aa236b-winter-2019/FlightBoards/README.md

# FlightBoards
Home of PCB Designs

### Notes: 
* Commit 2427577 Contains Motherboard, Solar Panel X and Solar Panel Y documents that correspond to first revision of these boards
* Commit daf960a contains Solar Panel Z documents that correspond to first revision
