aa236b-winter-2019/FlightBoards/CAD_Models/SolarCellY_v2_6milmag.SLDASM

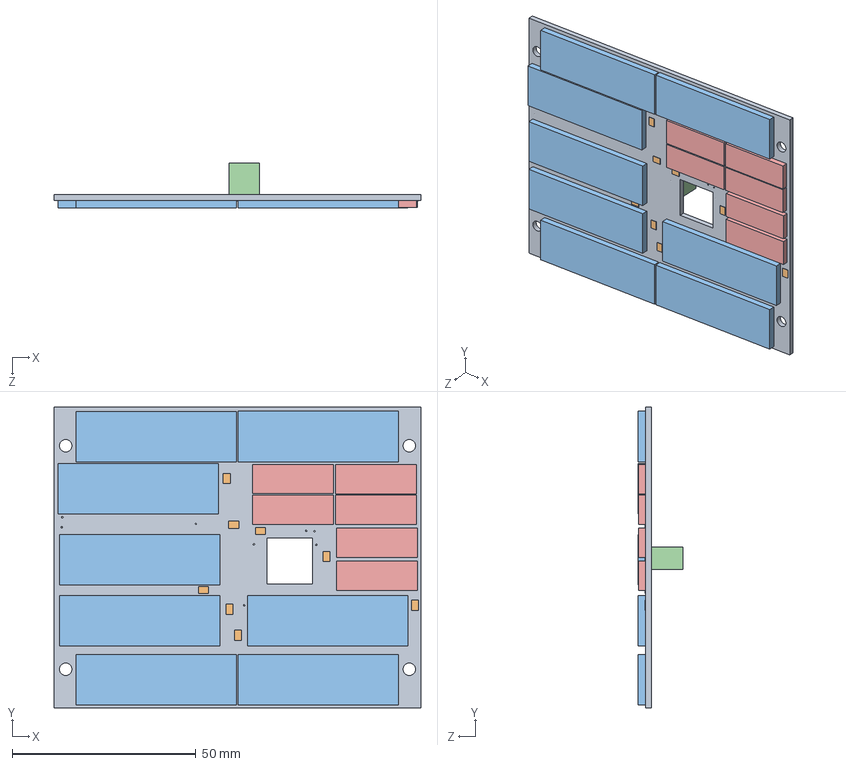
[picture p1: CAD file, 2019-02-27]
CAD_Models/SolarCellY_v2_6milmag.SLDASM
100.0 x 82.0 x 12.3 mm
Board.step
SB_DIODE.step x 8
SLMD121H04L.step x 8
M20-8760342.step
KXOB22-04X3F.step x 6
