aa236b-winter-2019/FlightBoards/CAD_Models/SolarZ.SLDASM

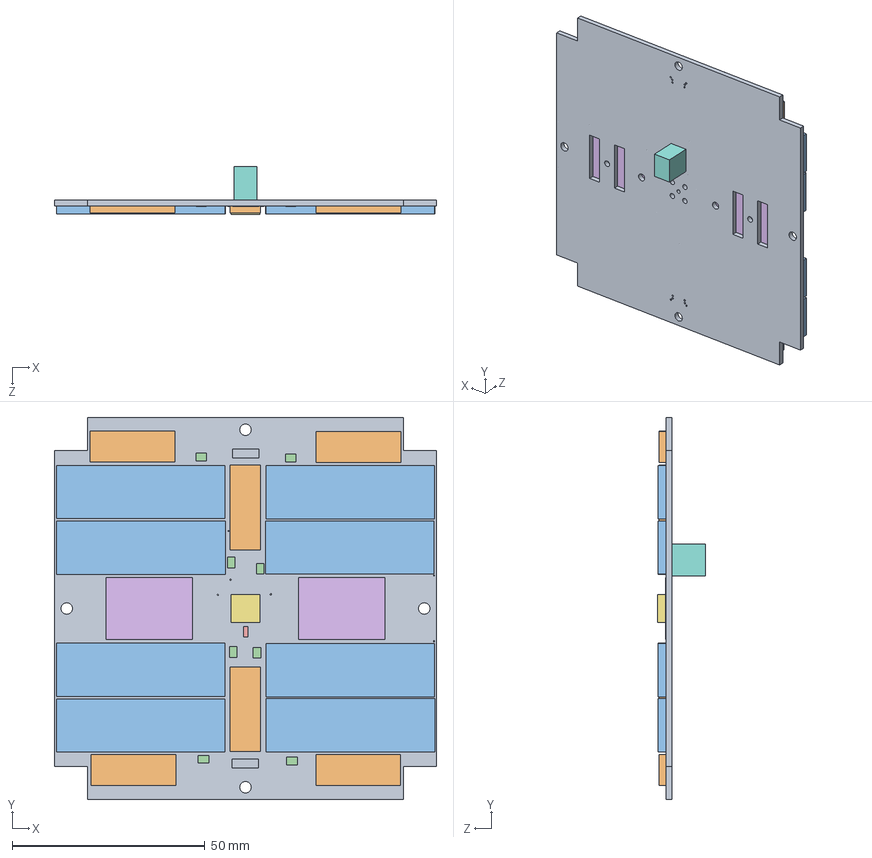
[picture p2: CAD file, 2019-02-27]
CAD_Models/SolarZ.SLDASM
99.0 x 99.0 x 12.5 mm
Board.step
KXOB22-04X3F.step x 6
SLMD121H04L.step x 8
SB_DIODE.step x 8
BALUN.step
TAPE.step x 2
BU-SMA-V.step
M20-8760342.step
BURN_WIRE.step x 2
