aa236b-winter-2019/FlightBoards/CAD_Models/SolarCellX_v2_6milmag.SLDASM

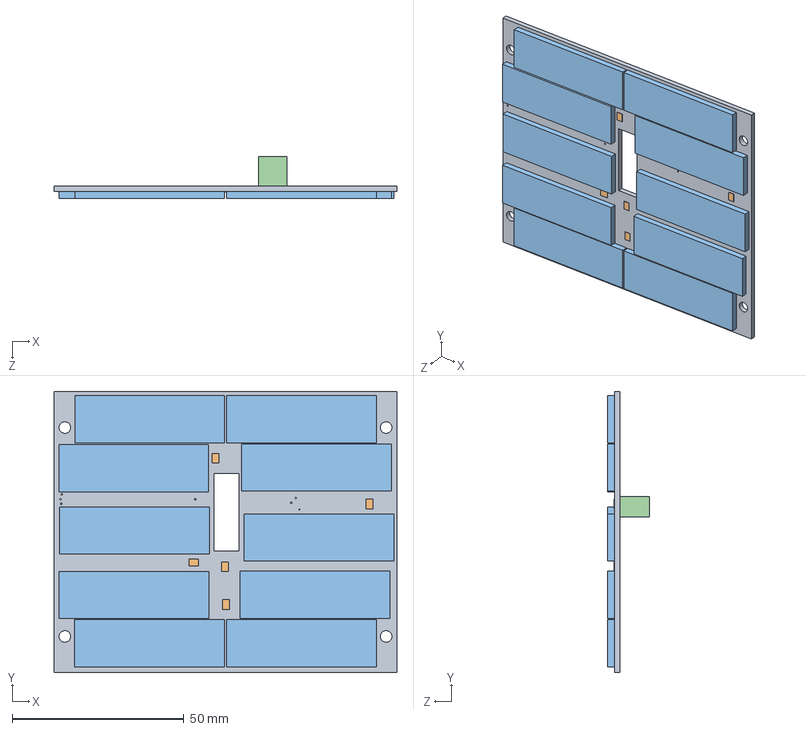
[picture p3: CAD file, 2019-02-27]
CAD_Models/SolarCellX_v2_6milmag.SLDASM
100.0 x 82.0 x 12.3 mm
Board.step
SB_DIODE.step x 5
SLMD121H04L.step x 10
M20-8760342.step
