aa236b-winter-2019/FlightBoards/CAD_Models/Part Models/GPS_Antenna.SLDPRT

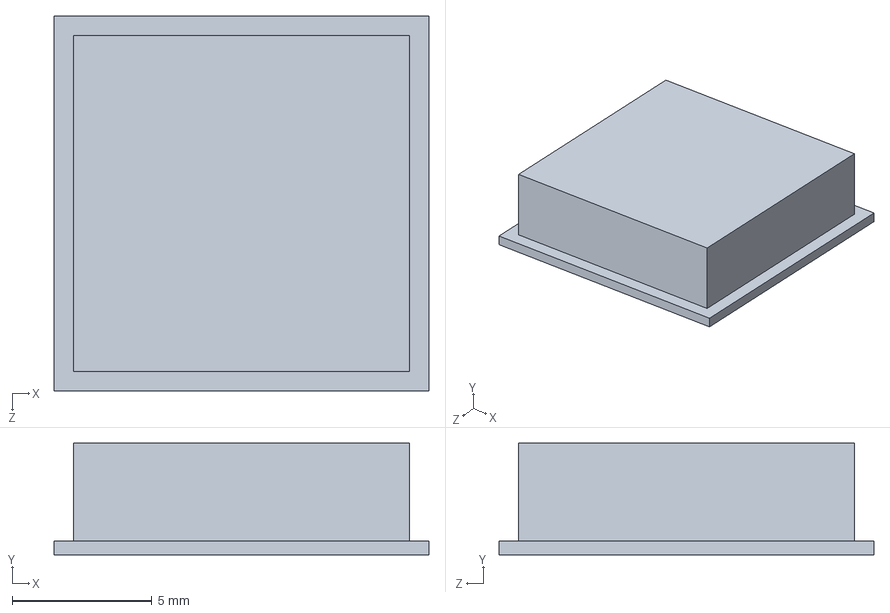
[picture p4: CAD file, 2019-02-12]
CAD_Models/Part Models/GPS_Antenna.SLDPRT
13.4 x 4.00 x 13.4 mm
