aa236b-winter-2019/FlightBoards/CAD_Models/Part Models/USBC_SMD.STEP

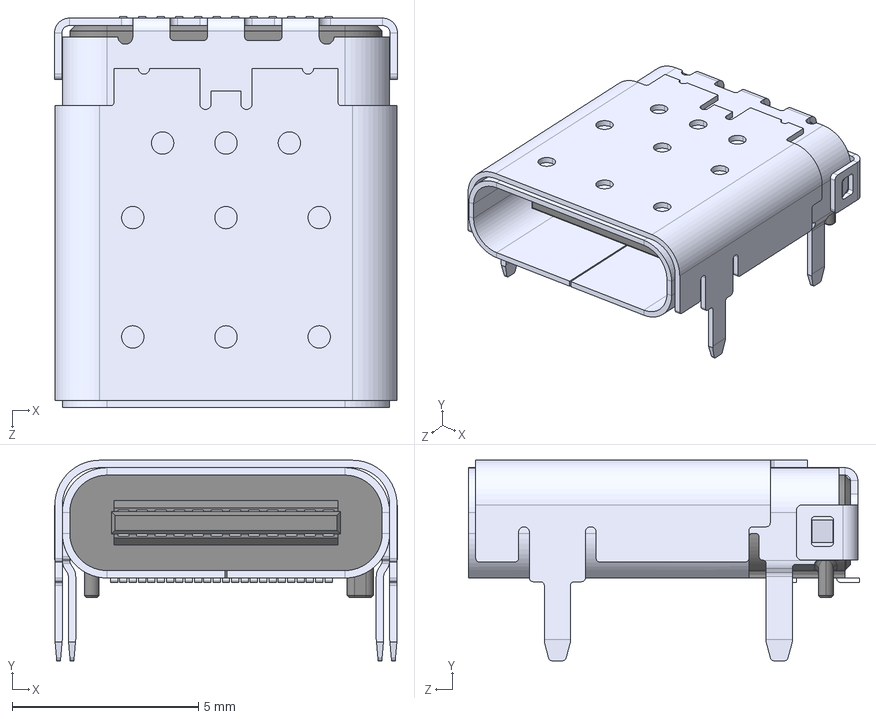
[picture p5: CAD file, 2019-02-08]
CAD_Models/Part Models/USBC_SMD.STEP
9.20 x 5.38 x 10.5 mm
