aa236b-winter-2019/FlightBoards/CAD_Models/Part Models/RFM-23BP.STEP

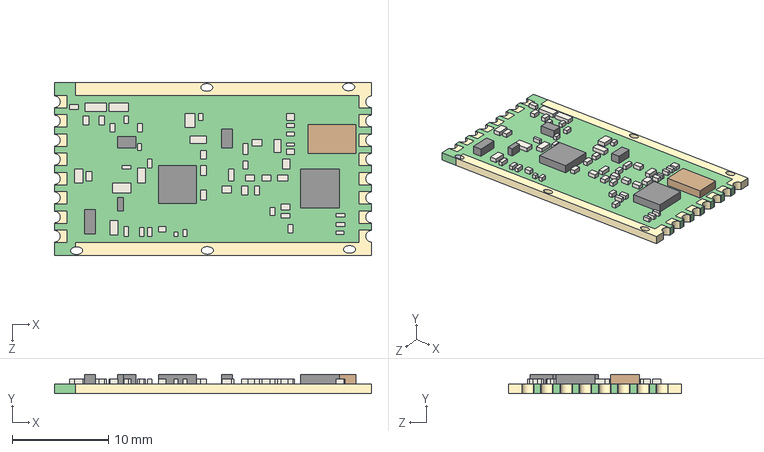
[picture p6: CAD file, 2019-02-08]
CAD_Models/Part Models/RFM-23BP.STEP
33.0 x 2.00 x 18.0 mm
