aa236b-winter-2019/FlightBoards/CAD_Models/MB_2.SLDPRT

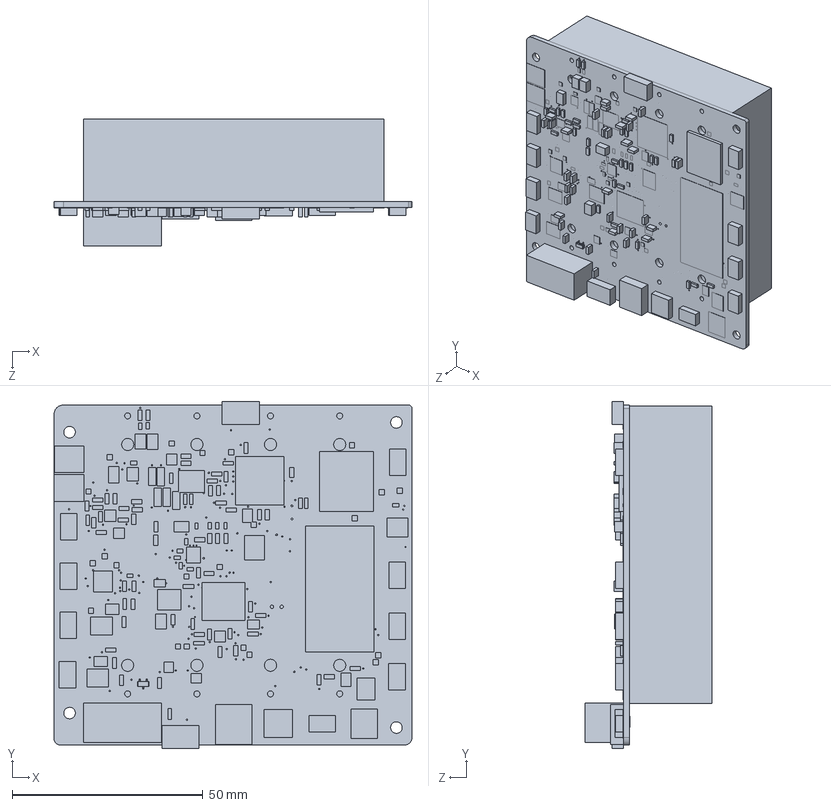
[picture p7: CAD file, 2019-02-12]
CAD_Models/MB_2.SLDPRT
93.9 x 91.1 x 33.2 mm
