aa236b-winter-2019/FlightBoards/(threads)

Thread 1 (2019-02-20):

Motherboard

mattpoole1, 2019-02-20:
- [ ] Measure and change battery pack footprint
- [ ] Check why USB-C footprint cutouts weren't drilled

GathererA, 2019-02-22:
[ ] Double check footprint for MCU

DamianLoya, 2019-02-25:
- [ ]  Add Reset Button
- [ ] Route Signals internally
- [ ] Switch USB C for USB Mini?

Thread 4 (2019-03-01):

Bao Bao Issues (H-Bridge Circuit)

domtero, 2019-03-01:
Bao Bao U11 is missing two pads now (burned off), will need to wire these.

Bao Bao U11 also likely linking VBATT and GROUND because of too much solder underneath, will need to remove U11 to check. Can check by C13 and C14, the ground and vbatt pins are connected. Might need to check U10 as well.

domtero, 2019-03-01:
Resolved second problem (VBATT + GROUND linked).

All H-bridge and burn wire components (aside from Relay) are mounted. Two pads on U11 are still missing.
