aa236b-winter-2019/FlightBoards/Motherboard/PandaSat_MB/MB_2S.pdf

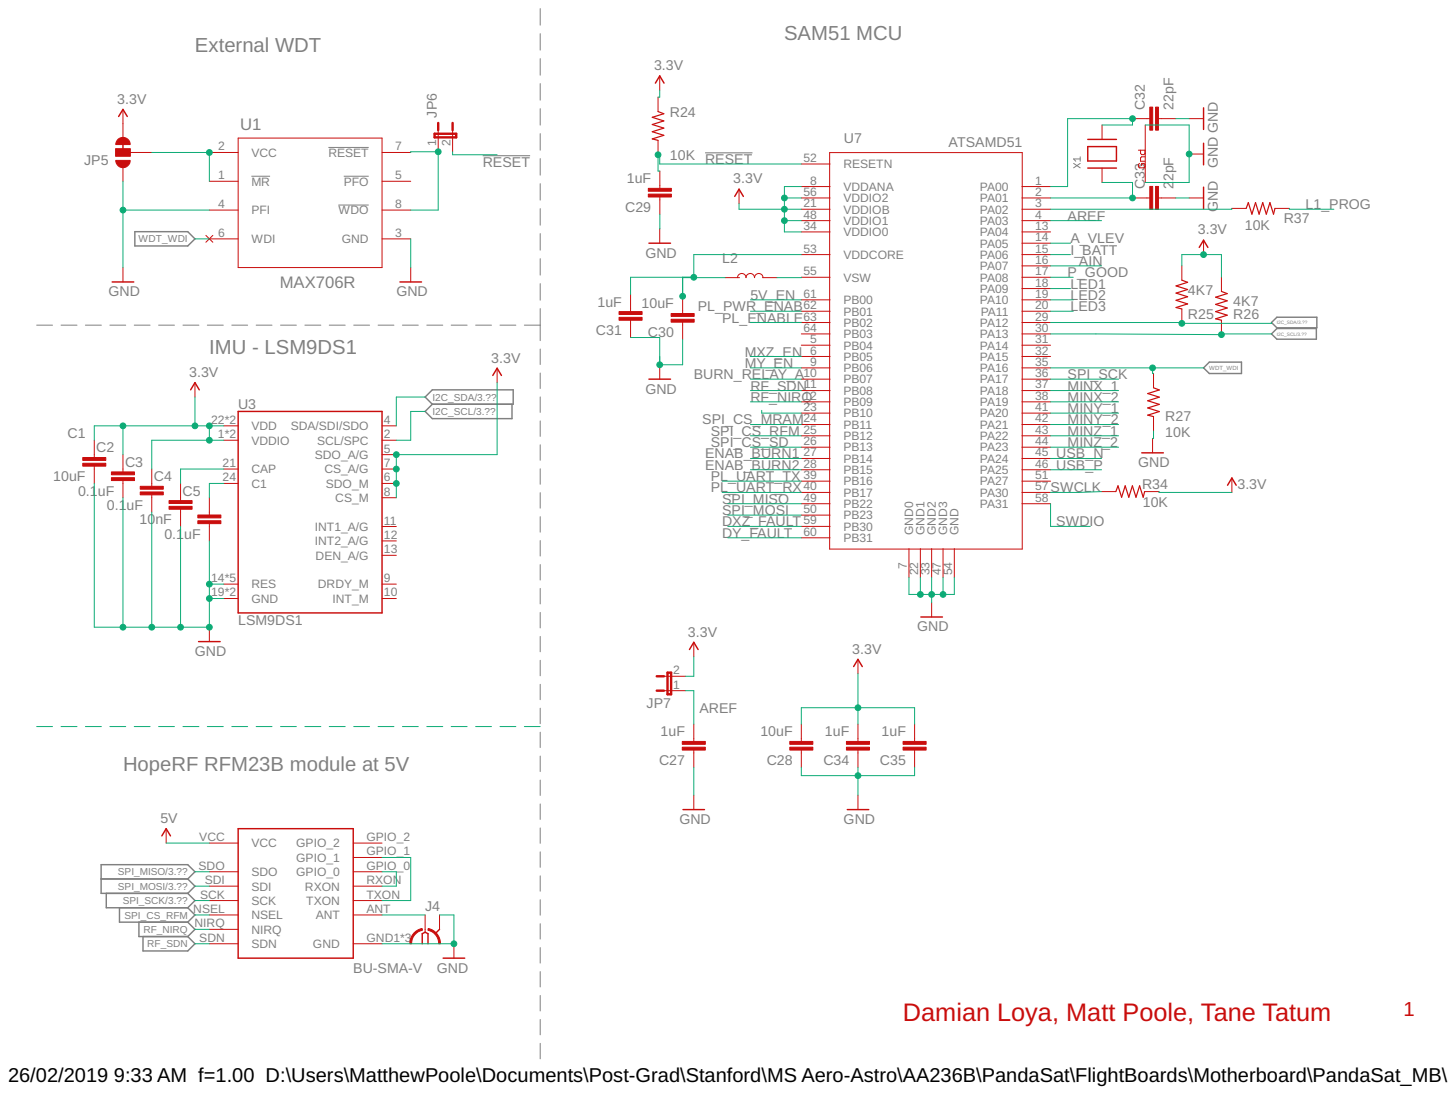
[picture p8: page 1]

26/02/2019 9:33 AM f=1.00 D:\Users\MatthewPoole\Documents\Post-Grad\Stanford\MS Aero-Astro\AA236B\PandaSat\FlightBoards\Motherboard\PandaSat_MB\MB_2.sch (Sheet: 1/4)

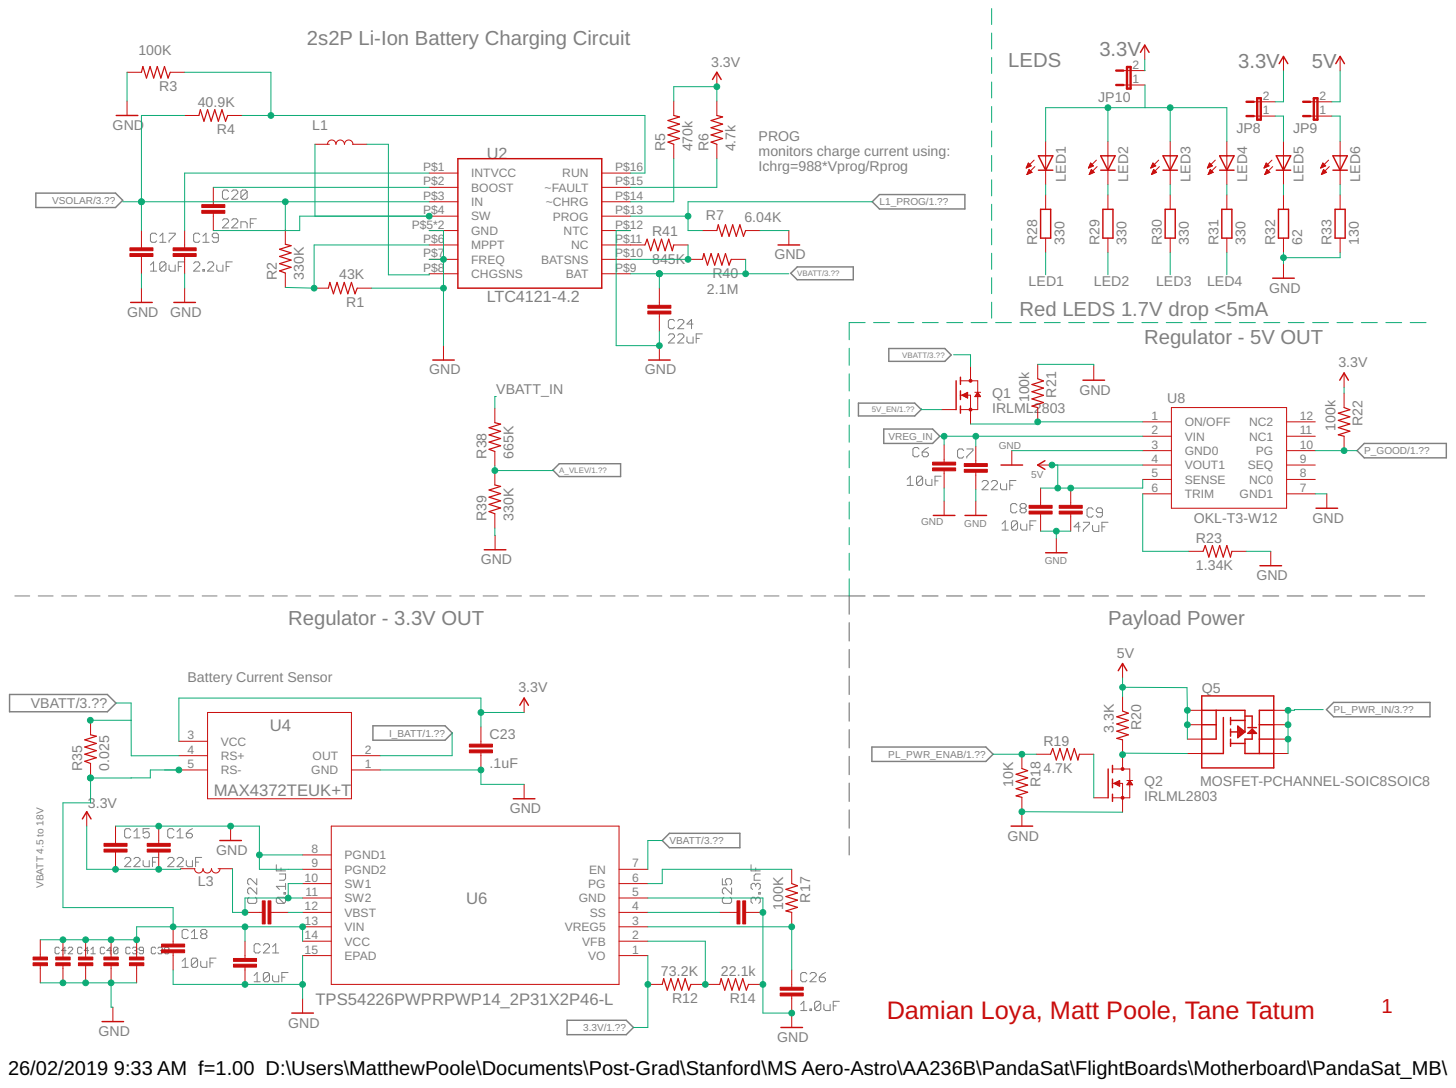
[picture p9: page 2]

2s2P Li-Ion Battery Charging Circuit

PROG monitors charge current using:

Battery Current Sensor Regulator - 3.3V OUT

26/02/2019 9:33 AM f=1.00 D:\Users\MatthewPoole\Documents\Post-Grad\Stanford\MS Aero-Astro\AA236B\PandaSat\FlightBoards\Motherboard\PandaSat_MB\MB_2.sch (Sheet: 2/4)

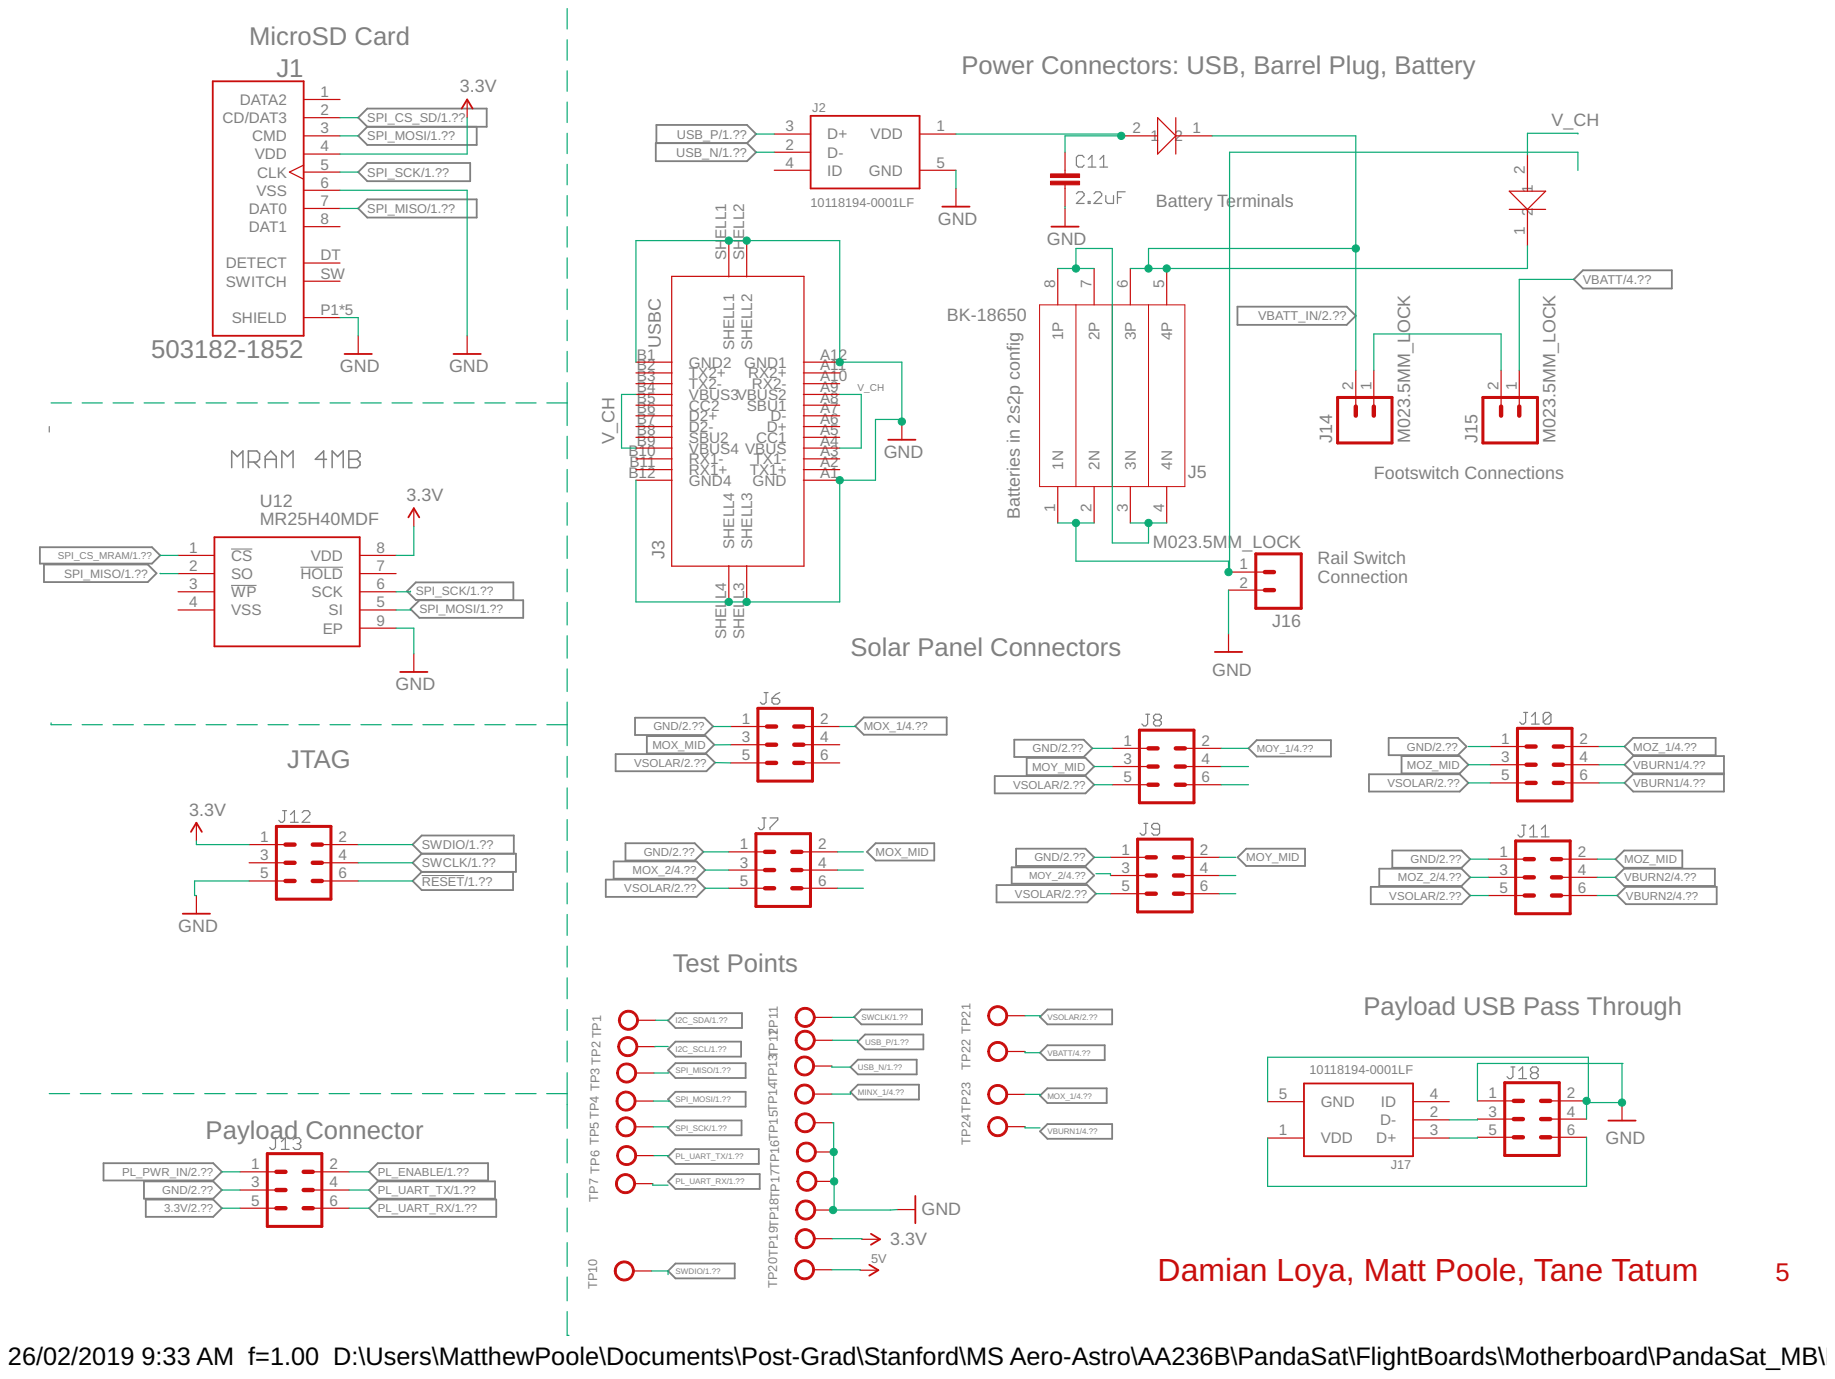
[picture p10: page 3]

Power Connectors: USB, Barrel Plug, Battery

Connection Solar Panel Connectors

Payload USB Pass Through

26/02/2019 9:33 AM f=1.00 D:\Users\MatthewPoole\Documents\Post-Grad\Stanford\MS Aero-Astro\AA236B\PandaSat\FlightBoards\Motherboard\PandaSat_MB\MB_2.sch (Sheet: 3/4)

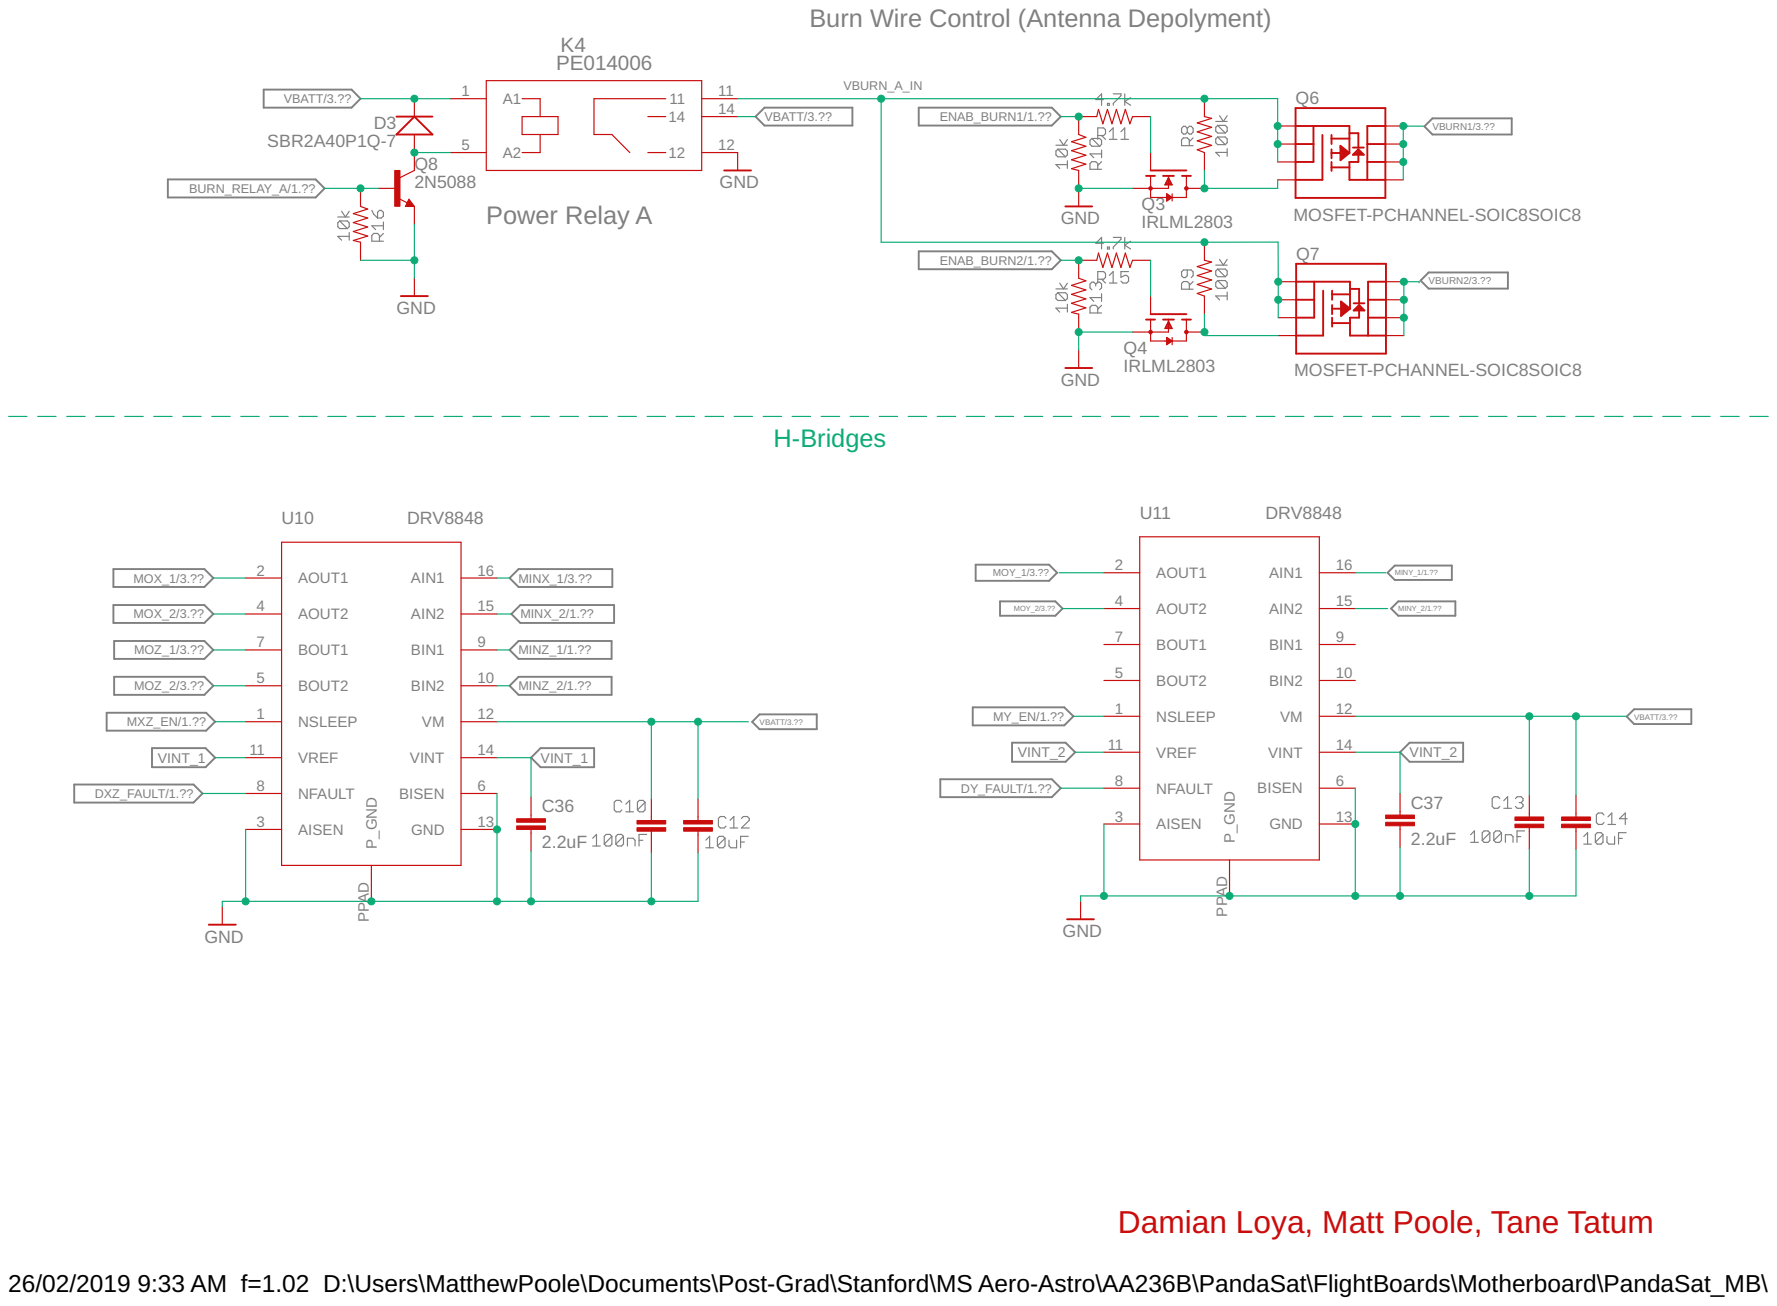
[picture p11: page 4]

Burn Wire Control (Antenna Depolyment)

Damian Loya, Matt Poole, Tane Tatum

26/02/2019 9:33 AM f=1.02 D:\Users\MatthewPoole\Documents\Post-Grad\Stanford\MS Aero-Astro\AA236B\PandaSat\FlightBoards\Motherboard\PandaSat_MB\MB_2.sch (Sheet: 4/4)
