aa236b-winter-2019/FlightBoards/Motherboard/PandaSat_MB/MB_2.pdf

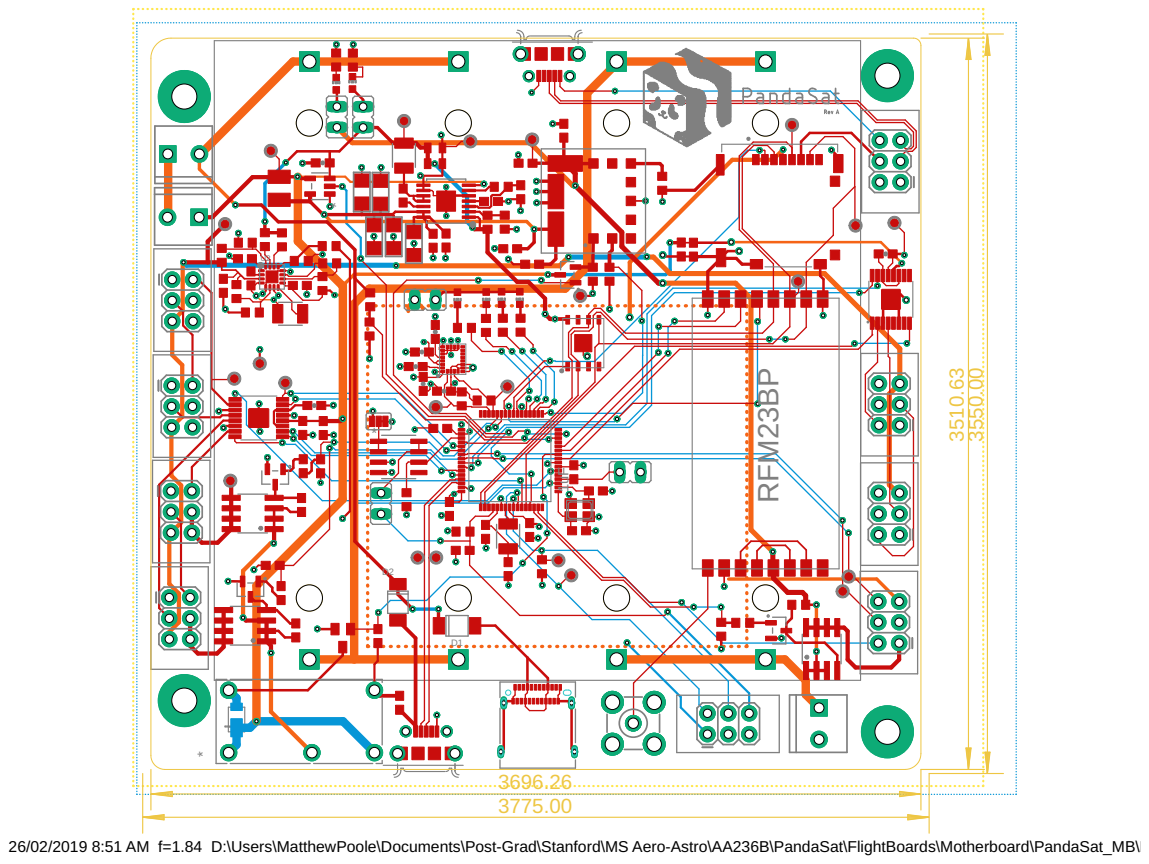
[picture p12: page 1]

26/02/2019 8:51 AM f=1.84 D:\Users\MatthewPoole\Documents\Post-Grad\Stanford\MS Aero-Astro\AA236B\PandaSat\FlightBoards\Motherboard\PandaSat_MB\MB_2.brd
