aa236b-winter-2019/FlightBoards/Motherboard/PandaSat_MB/MB_2.brd

## EAGLE design Motherboard/PandaSat_MB/MB_2.brd (2019-03-15)

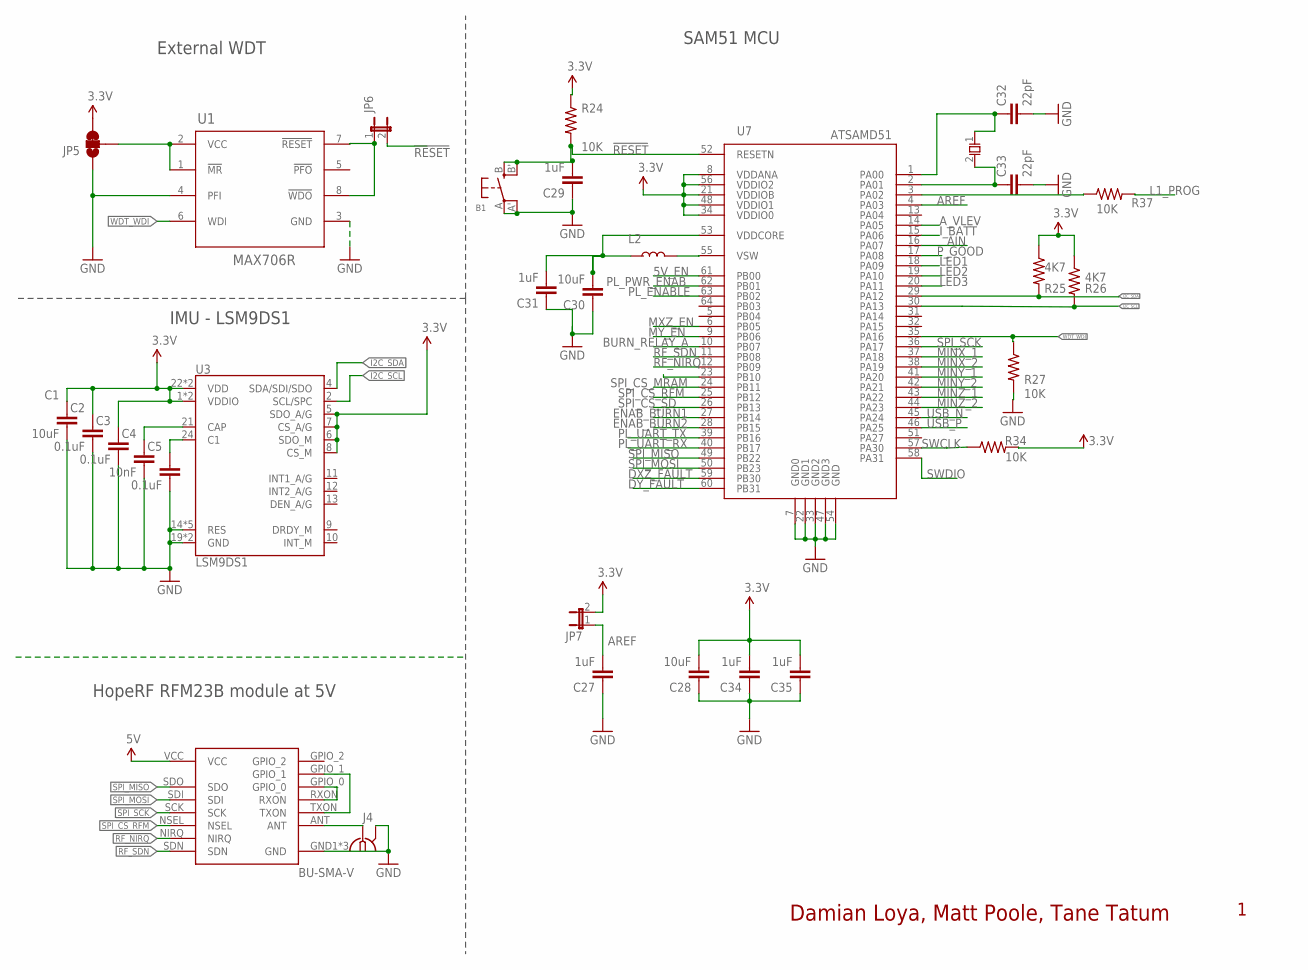
[picture p13: schematic MB_2.sch, sheet 1, Avionics]

Parts:
B1: SWITCH_TACT_SMT4.6X2.8; BTN_KMR2_4.6X2.8
C1: 10uF; 0603-CAP
C2, C3, C5: 0.1uF; 0603-CAP
C4: 10nF; 0603-CAP
C27, C29, C31, C34, C35: 1uF; C0603
C28, C30: 10uF; C0603
C32, C33: 22pF; C0603
J4: BU-SMA-V
JP5: JUMPER-PAD-3-2OF3_NC_BY_TRACE_SMALL; PAD-JUMPER-3-2OF3_NC_BY_TRACE_YES_SILK_FULL_BOX
JP6, JP7: JP1E; JP1
L2: 10uH; 1210
R24, R27, R34, R37: 10K; R0603
R25, R26: 4K7; R0603
U1: MAX706R; SO8
U3: LSM9DS1; LGA24-8X4
U5: RFM23BP
U7: ATSAMD51; TQFP-64
X1: ECX-31B

Connections:
3.3V: C1.1, C2.1, C3.1, C28.2, C34.2, C35.2, JP5.3, JP7.2, R24.1, R25.1, R26.1, R34.2, U3.1 (VDDIO), U3.3 (VDDIO), U3.5 (SDO_A/G), U3.6 (SDO_M), U3.7 (CS_A/G), U3.8 (CS_M), U3.22 (VDD), U3.23 (VDD), U7.8 (VDDANA), U7.21 (VDDIOB), U7.34 (VDDIO0), U7.48 (VDDIO1), U7.56 (VDDIO2); also elsewhere on the board
5V: U5.VCC; also elsewhere on the board
5V_EN: U7.61 (PB00); also elsewhere on the board
!RESET: B1.B (S), B1.B' (S1), C29.2, JP6.2, R24.2, U7.52 (RESETN); also elsewhere on the board
AIN: U7.16 (PA07)
AREF: C27.2, JP7.1, U7.4 (PA03)
A_VLEV: U7.14 (PA05); also elsewhere on the board
BURN_RELAY_A: U7.10 (PB07); also elsewhere on the board
DXZ_FAULT: U7.59 (PB30); also elsewhere on the board
DY_FAULT: U7.60 (PB31); also elsewhere on the board
ENAB_BURN1: U7.27 (PB14); also elsewhere on the board
ENAB_BURN2: U7.28 (PB15); also elsewhere on the board
GND: B1.A, B1.A' (P1), C1.2, C2.2, C3.2, C4.2, C5.2, C27.1, C28.1, C29.1, C30.1, C31.1, C32.2, C33.2, C34.1, C35.1, J4.2, J4.3 (2), J4.4 (2), J4.5 (2), JP5.1, R27.2, U1.3 (GND), U1.4 (PFI), U3.14 (RES), U3.15 (RES), U3.16 (RES), U3.17 (RES), U3.18 (RES), U3.19 (GND), U3.20 (GND), U5.GND1 (GND), U5.GND2 (GND), U5.GND3 (GND), U7.7 (GND0), U7.22 (GND1), U7.33 (GND2), U7.47 (GND3), U7.54 (GND); also elsewhere on the board
I2C_SCL: R26.2, U3.2 (SCL/SPC), U7.30 (PA13)
I2C_SDA: R25.2, U3.4 (SDA/SDI/SDO), U7.29 (PA12)
I_BATT: U7.15 (PA06); also elsewhere on the board
L1_PROG: R37.2; also elsewhere on the board
LED1: U7.18 (PA09); also elsewhere on the board
LED2: U7.19 (PA10); also elsewhere on the board
LED3: U7.20 (PA11); also elsewhere on the board
LED4: U7.23 (PB10); also elsewhere on the board
MINX_1: U7.37 (PA18); also elsewhere on the board
MINX_2: U7.38 (PA19); also elsewhere on the board
MINY_1: U7.41 (PA20); also elsewhere on the board
MINY_2: U7.42 (PA21); also elsewhere on the board
MINZ_1: U7.43 (PA22); also elsewhere on the board
MINZ_2: U7.44 (PA23); also elsewhere on the board
MXZ_EN: U7.6 (PB05); also elsewhere on the board
MY_EN: U7.9 (PB06); also elsewhere on the board
unnamed: JP6.1, U1.7 (!RESET), U1.8 (!WDO)
unnamed: C4.1, U3.21 (CAP)
unnamed: C5.1, U3.24 (C1)
unnamed: JP5.2, U1.1 (!MR), U1.2 (VCC)
unnamed: L2.2, U7.55 (VSW)
unnamed: C32.1, U7.1 (PA00), X1.1
unnamed: J4.1, U5.ANT
unnamed: U5.GPIO_0, U5.RXON
unnamed: U5.GPIO_1, U5.TXON
unnamed: C30.2, C31.2, L2.1, U7.53 (VDDCORE)
unnamed: C33.1, U7.2 (PA01), X1.2
unnamed: R37.1, U7.3 (PA02)
PL_ENABLE: U7.63 (PB02); also elsewhere on the board
PL_PWR_ENAB: U7.62 (PB01); also elsewhere on the board
PL_UART_RX: U7.40 (PB17); also elsewhere on the board
PL_UART_TX: U7.39 (PB16); also elsewhere on the board
P_GOOD: U7.17 (PA08); also elsewhere on the board
RF_NIRQ: U5.NIRQ, U7.12 (PB09)
RF_SDN: U5.SDN, U7.11 (PB08)
SPI_CS_MRAM: U7.24 (PB11); also elsewhere on the board
SPI_CS_RFM: U5.NSEL, U7.25 (PB12)
SPI_CS_SD: U7.26 (PB13); also elsewhere on the board
SPI_MISO: U5.SDO, U7.49 (PB22); also elsewhere on the board
SPI_MOSI: U5.SDI, U7.50 (PB23); also elsewhere on the board
SPI_SCK: U5.SCK, U7.36 (PA17); also elsewhere on the board
SWCLK: R34.1, U7.57 (PA30); also elsewhere on the board
SWDIO: U7.58 (PA31); also elsewhere on the board
USB_N: U7.45 (PA24); also elsewhere on the board
USB_P: U7.46 (PA25); also elsewhere on the board
WDT_WDI: R27.1, U1.6 (WDI), U7.35 (PA16)

Notes on the sheet:
IMU - LSM9DS1
External WDT
HopeRF RFM23B module at 5V
SAM51 MCU
Damian Loya, Matt Poole, Tane Tatum

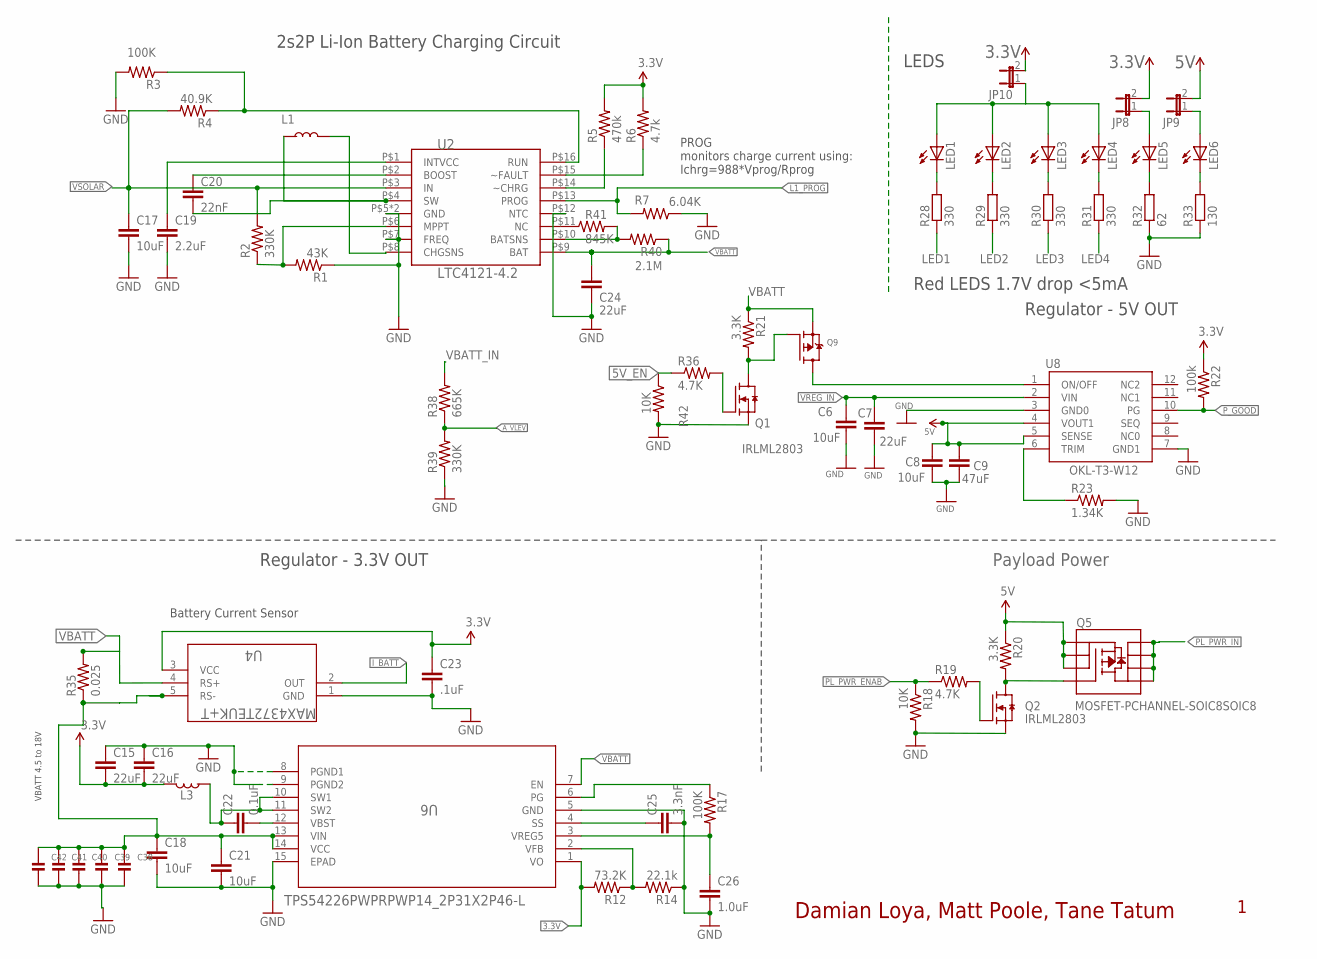
[picture p14: schematic MB_2.sch, sheet 2, Power]

Parts:
C6, C8, C17, C18, C21: 10uF; 0603
C7, C24: 22uF; 0603
C9: 47uF; 0603
C15, C16: 22uF; 0805
C19: 2.2uF; 0603
C20: 22nF; 0603
C22: 0.1uF; 0603
C23: .1uF; 0603-CAP
C25: 3.3nF; 0603
C26: 1.0uF; 0603
C38, C39, C40, C41, C42: CAP_CERAMIC1206; 1206
JP8, JP9, JP10: JP1E; JP1
L1: 56uH; 1210
L3: 3.3uH; 1210
LED1, LED2, LED3, LED4, LED5, LED6: LEDCHIP-LED0603; CHIP-LED0603
Q1, Q2: IRLML2803; SOT-23
Q5: MOSFET-PCHANNEL-SOIC8SOIC8; SO08
Q9: MOSFET-PWIDE; SOT23-WIDE
R1: 43K; R0603
R2, R39: 330K; R0603
R3, R17: 100K; R0603
R4: 40.9K; R0603
R5: 470k; R0603
R6: 4.7k; R0603
R7: 6.04K; R0603
R12: 73.2K; R0603
R14: 22.1k; R0603
R18, R42: 10K; R0603
R19, R36: 4.7K; R0603
R20, R21: 3.3K; R0603
R22: 100k; R0603
R23: 1.34K; R0603
R28, R29, R30, R31: 330; R0603
R32: 62; R0603
R33: 130; R0603
R35: 0.025; R1210
R38: 665K; R0603
R40: 2.1M; R0603
R41: 845K; R0603
U2: LTC4121-4.2; QFN-16-PAD
U4: MAX4372TEUK+T; 21-0057F
U6: TPS54226PWPRPWP14_2P31X2P46-L; PWP14_2P31X2P46-L
U8: OKL-T3-W12

Connections:
3.3V: C15.2, C16.2, C23.1, JP8.2, JP10.2, L3.2, R5.2, R6.2, R12.2, R22.1, U4.3 (VCC), U6.1 (VO); also elsewhere on the board
5V: C8.1, C9.1, JP9.2, Q5.1 (S), Q5.2 (S), Q5.3 (S), R20.1, U8.4 (VOUT1), U8.5 (SENSE); also elsewhere on the board
5V_EN: R36.1, R42.1; also elsewhere on the board
A_VLEV: R38.1, R39.2; also elsewhere on the board
GND: C6.2, C7.2, C8.2, C9.2, C15.1, C16.1, C17.2, C18.2, C19.2, C21.2, C23.2, C24.2, C25.2, C26.2, C38.2, C39.2, C40.2, C41.2, C42.2, Q1.2 (S), Q2.2 (S), R1.1, R3.2, R7.1, R14.1, R18.2, R23.2, R32.1, R33.1, R39.1, R42.2, U2.P$5 (GND), U2.P$7 (FREQ), U2.P$12 (NTC), U2.P$17 (GND), U4.1 (GND), U6.5 (GND), U6.8 (PGND1), U6.9 (PGND2), U6.15 (EPAD), U8.3 (GND0), U8.7 (GND1); also elsewhere on the board
I_BATT: U4.2 (OUT); also elsewhere on the board
L1_CHG: R3.1, R4.1, U2.P$16 (RUN)
L1_FAULTN: R6.1, U2.P$15 (~FAULT)
L1_PROG: R7.2, U2.P$13 (PROG); also elsewhere on the board
LED1: R28.1; also elsewhere on the board
LED2: R29.1; also elsewhere on the board
LED3: R30.1; also elsewhere on the board
LED4: R31.1; also elsewhere on the board
unnamed: C22.1, L3.1, U6.10 (SW1), U6.11 (SW2)
unnamed: L1.2, U2.P$8 (CHGSNS)
unnamed: C20.2, L1.1, U2.P$4 (SW)
unnamed: C20.1, U2.P$2 (BOOST)
unnamed: Q2.1 (G), R19.2
unnamed: C19.1, U2.P$1 (INTVCC)
unnamed: Q2.3 (D), Q5.4 (G), R20.2
unnamed: R1.2, R2.1, U2.P$6 (MPPT)
unnamed: C22.2, U6.12 (VBST)
unnamed: R5.1, U2.P$14 (~CHRG)
unnamed: R40.2, R41.2, U2.P$10 (BATSNS)
unnamed: Q1.3 (D), Q9.1 (G), R21.2
unnamed: R23.1, U8.6 (TRIM)
unnamed: Q1.1 (G), R36.2
unnamed: LED1.C, R28.2
unnamed: Q9.3 (D), U8.1 (ON/OFF)
unnamed: LED2.C, R29.2
unnamed: C26.1, R17.2, U6.3 (VREG5)
unnamed: LED3.C, R30.2
unnamed: LED4.C, R31.2
unnamed: LED5.C, R32.2
unnamed: LED6.C, R33.2
unnamed: C25.1, U6.4 (SS)
unnamed: R12.1, R14.2, U6.2 (VFB)
unnamed: JP8.1, LED5.A
unnamed: R41.1, U2.P$11 (NC)
unnamed: JP9.1, LED6.A
unnamed: JP10.1, LED1.A, LED2.A, LED3.A, LED4.A
PGOOD: R17.1, U6.6 (PG)
PL_PWR_ENAB: R18.1, R19.1; also elsewhere on the board
PL_PWR_IN: Q5.5 (D), Q5.6 (D), Q5.7 (D), Q5.8 (D); also elsewhere on the board
P_GOOD: R22.2, U8.10 (PG); also elsewhere on the board
VBATT: C24.1, Q9.2 (S), R21.1, R35.2, R40.1, U2.P$9 (BAT), U4.4 (RS+), U6.7 (EN); also elsewhere on the board
VBATT_IN: R38.2; also elsewhere on the board
VREG_IN: C6.1, C7.1, C18.1, C21.1, C38.1, C39.1, C40.1, C41.1, C42.1, R35.1, U4.5 (RS-), U6.13 (VIN), U6.14 (VCC), U8.2 (VIN)
VSOLAR: C17.1, R2.2, R4.2, U2.P$3 (IN); also elsewhere on the board

Notes on the sheet:
Battery Current Sensor
Payload Power
Regulator - 3.3V OUT
VBATT 4.5 to 18V
Regulator - 5V OUT
2s2P Li-Ion Battery Charging Circuit
PROG monitors charge current using: Ichrg=988*Vprog/Rprog
Damian Loya, Matt Poole, Tane Tatum
LEDS
Red LEDS 1.7V drop <5mA

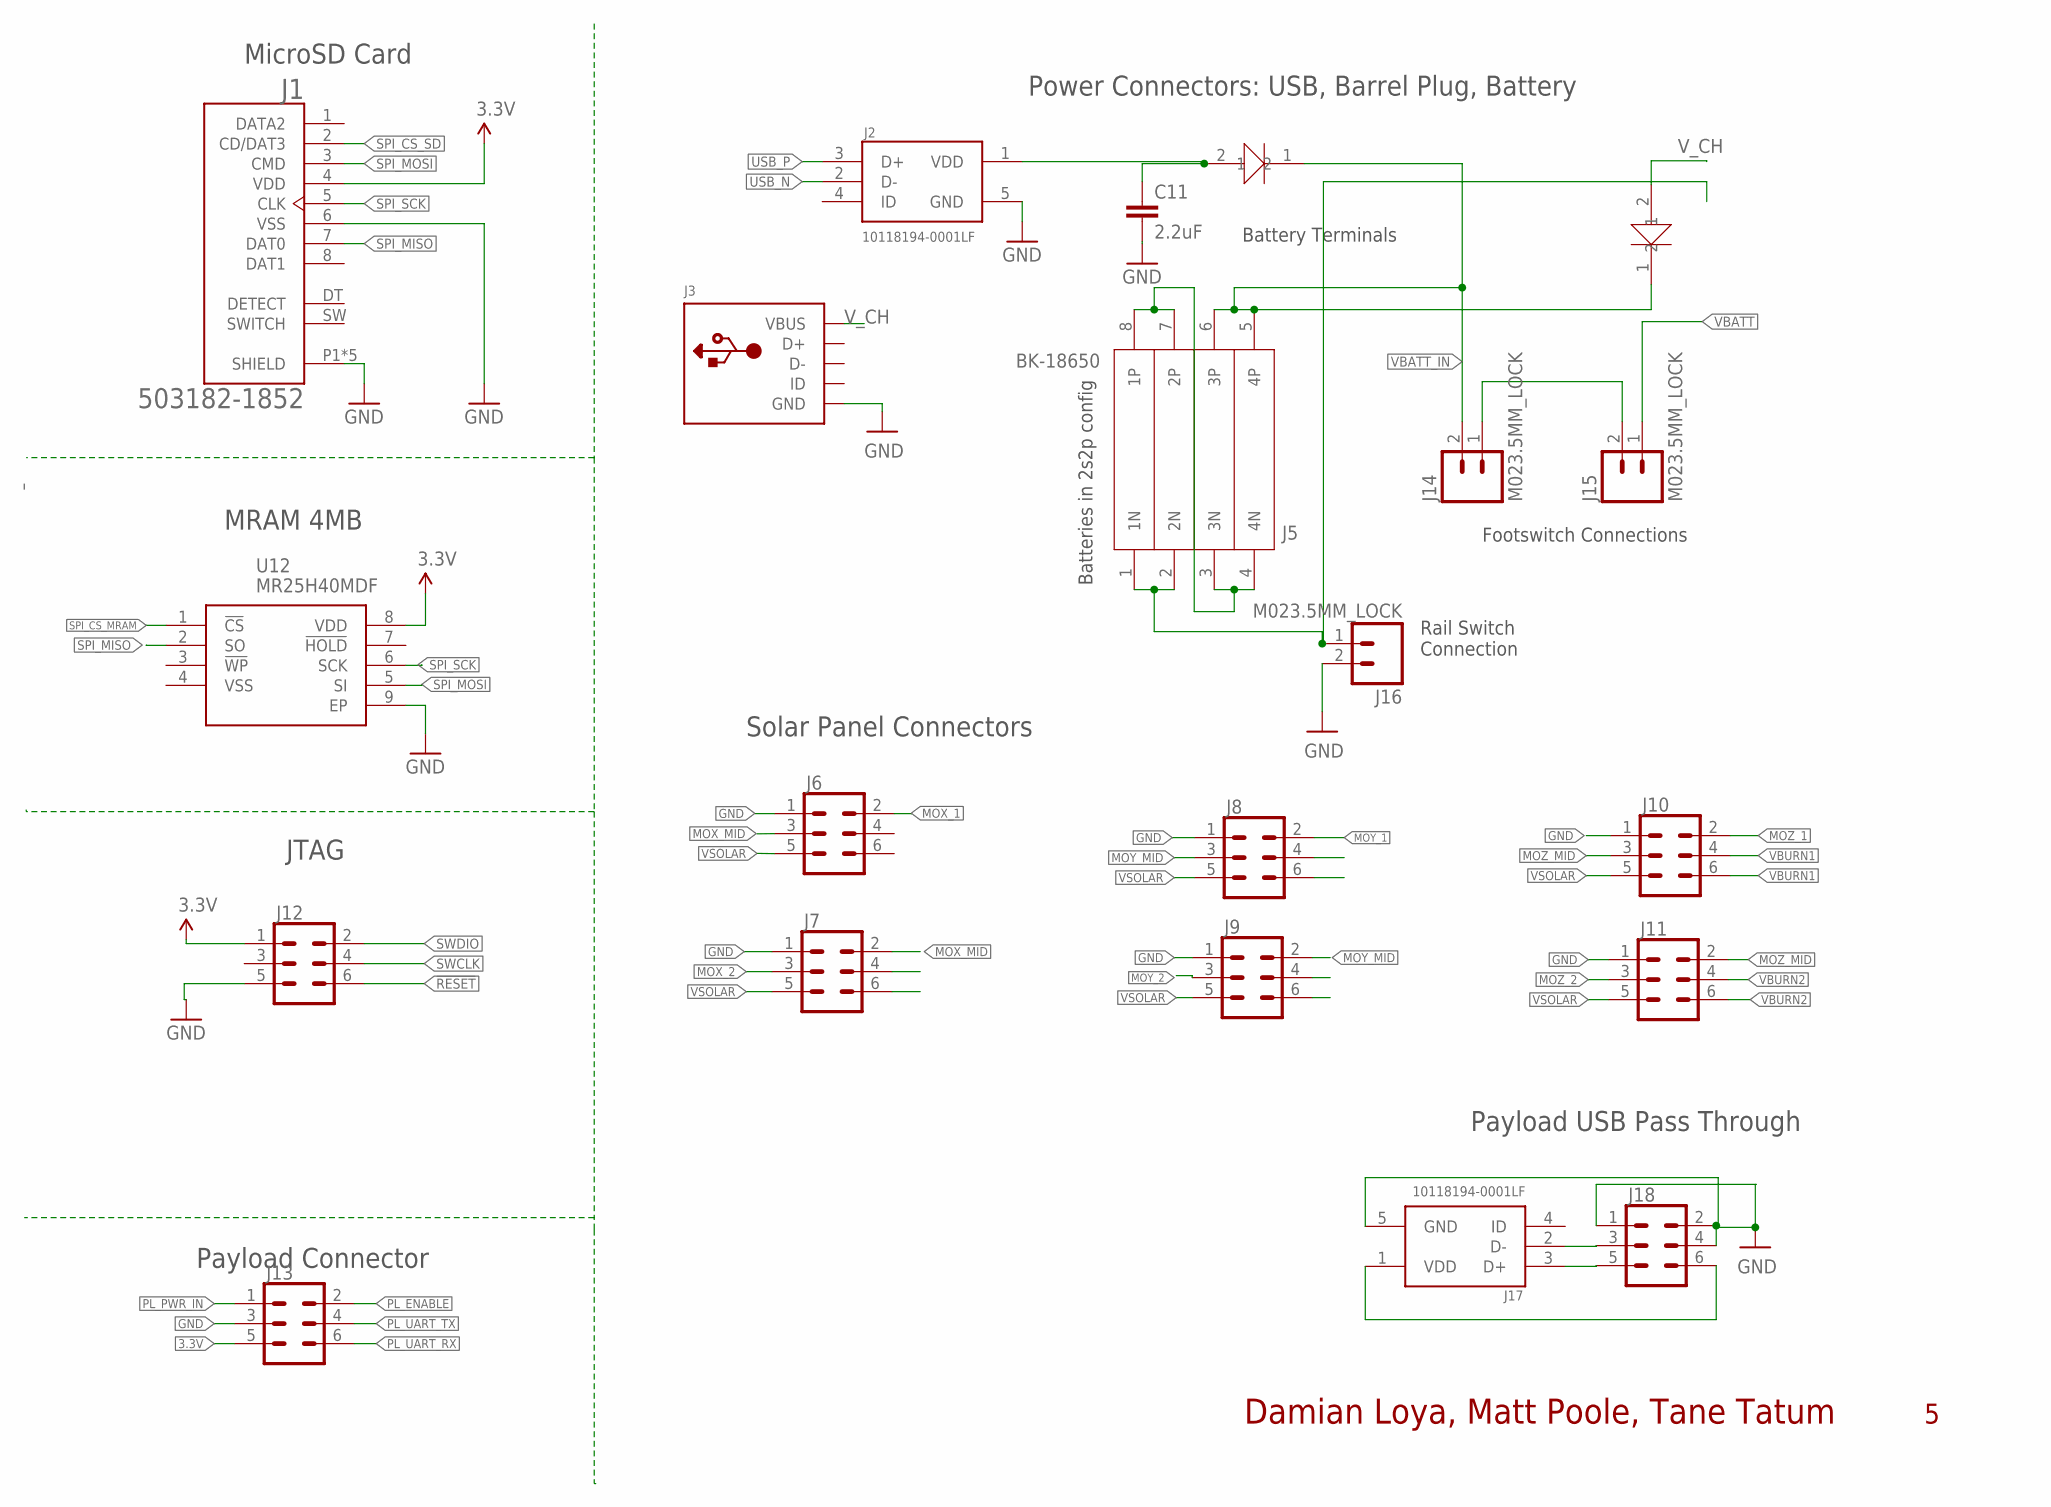
[picture p15: schematic MB_2.sch, sheet 3, Connectors]

Parts:
C11: 2.2uF; 0603
D1, D2: RBR5LAM60ATF; SOD-128
J1: 503182-1852; MOLEX_503182-1852
J2, J17: 10118194-0001LF; FRAMATOME_10118194-0001LF
J3: USBMOLEX; USB-MINIB-THM-MOLEX
J5: BK-18650
J6, J7, J8, J9, J10, J11, J12, J13, J18: CONN_03X22X3_SILK_MALE_PTH; 2X3
J14, J15, J16: M023.5MM_LOCK; SCREWTERMINAL-3.5MM-2_LOCK
U12: MR25H40MDF; SON127P600X500X90-9N

Connections:
3.3V: J1.4 (VDD), J12.1, J13.5, U12.8 (VDD); also elsewhere on the board
!RESET: J12.6; also elsewhere on the board
GND: C11.2, J1.6 (VSS), J1.P1 (SHIELD), J1.P2 (SHIELD), J1.P3 (SHIELD), J1.P4 (SHIELD), J1.P5 (SHIELD), J2.5 (GND), J3.GND, J6.1, J7.1, J8.1, J9.1, J10.1, J11.1, J12.5, J13.3, J16.2, J17.5 (GND), J18.1, J18.2, J18.4, U12.9 (EP); also elsewhere on the board
MOX_1: J6.2; also elsewhere on the board
MOX_2: J7.3; also elsewhere on the board
MOX_MID: J6.3, J7.2
MOY_1: J8.2; also elsewhere on the board
MOY_2: J9.3; also elsewhere on the board
MOY_MID: J8.3, J9.2
MOZ_1: J10.2; also elsewhere on the board
MOZ_2: J11.3; also elsewhere on the board
MOZ_MID: J10.3, J11.2
unnamed: J14.1, J15.2
unnamed: C11.1, D2.2, J2.1 (VDD)
unnamed: J17.2 (D-), J18.3
unnamed: J17.3 (D+), J18.5
unnamed: J17.1 (VDD), J18.6
unnamed: J5.3 (3N), J5.4 (4N), J5.7 (2P), J5.8 (1P)
unnamed: J5.1 (1N), J5.2 (2N), J16.1
PL_ENABLE: J13.2; also elsewhere on the board
PL_PWR_IN: J13.1; also elsewhere on the board
PL_UART_RX: J13.6; also elsewhere on the board
PL_UART_TX: J13.4; also elsewhere on the board
SPI_CS_MRAM: U12.1 (!CS); also elsewhere on the board
SPI_CS_SD: J1.2 (CD/DAT3); also elsewhere on the board
SPI_MISO: J1.7 (DAT0), U12.2 (SO); also elsewhere on the board
SPI_MOSI: J1.3 (CMD), U12.5 (SI); also elsewhere on the board
SPI_SCK: J1.5 (CLK), U12.6 (SCK); also elsewhere on the board
SWCLK: J12.4; also elsewhere on the board
SWDIO: J12.2; also elsewhere on the board
USB_N: J2.2 (D-); also elsewhere on the board
USB_P: J2.3 (D+); also elsewhere on the board
VBATT: J15.1; also elsewhere on the board
VBATT_IN: D1.1, D2.1, J5.5 (4P), J5.6 (3P), J14.2; also elsewhere on the board
VBURN1: J10.4, J10.6; also elsewhere on the board
VBURN2: J11.4, J11.6; also elsewhere on the board
VSOLAR: J6.5, J7.5, J8.5, J9.5, J10.5, J11.5; also elsewhere on the board
V_CH: D1.2, J3.VBUS

Notes on the sheet:
Damian Loya, Matt Poole, Tane Tatum
JTAG
Power Connectors: USB, Barrel Plug, Battery
MicroSD Card
MRAM 4MB
Footswitch Connections
Battery Terminals
Rail Switch Connection
Solar Panel Connectors
Payload Connector
Batteries in 2s2p config
Payload USB Pass Through

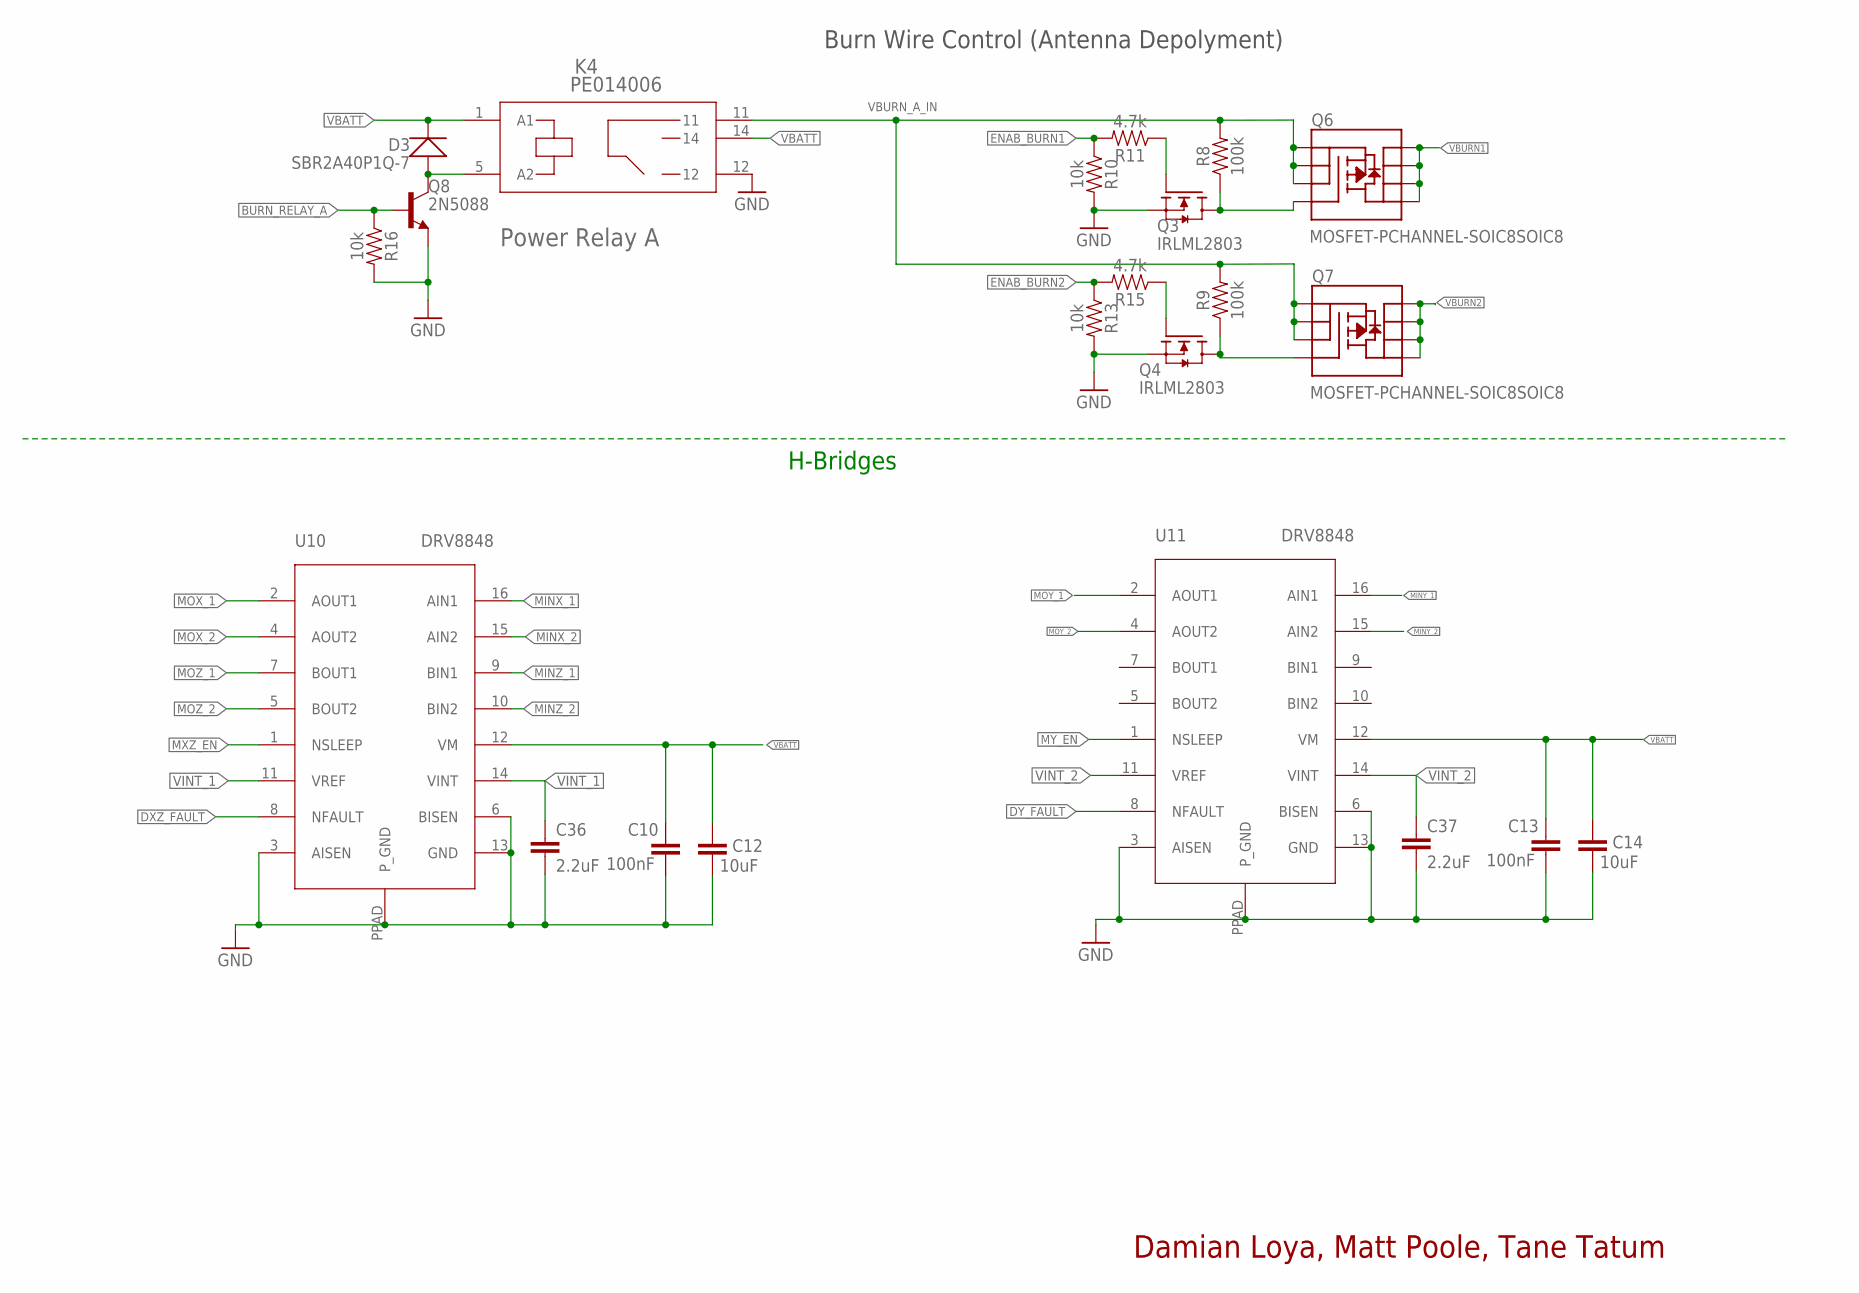
[picture p16: schematic MB_2.sch, sheet 4, Burn Wires and H-Bridges]

Parts:
C10, C13: 100nF; 0603
C12, C14: 10uF; 0603
C36, C37: 2.2uF; 0603-CAP; VOLTAGE 6.3V
D3: SBR2A40P1Q-7; PWRDI-123
K4: PE014006; RELAY5-PE_CO
Q3, Q4: IRLML2803; SOT-23
Q6, Q7: MOSFET-PCHANNEL-SOIC8SOIC8; SO08
Q8: 2N5088; SOT23
R8, R9: 100k; 0603
R10, R13, R16: 10k; 0603
R11, R15: 4.7k; 0603
U10, U11: DRV8848; HTSSOP

Connections:
BURN_RELAY_A: Q8.1 (B), R16.1; also elsewhere on the board
DXZ_FAULT: U10.8 (NFAULT); also elsewhere on the board
DY_FAULT: U11.8 (NFAULT); also elsewhere on the board
ENAB_BURN1: R10.1, R11.2; also elsewhere on the board
ENAB_BURN2: R13.1, R15.2; also elsewhere on the board
GND: C10.2, C12.2, C13.2, C14.2, C36.2, C37.2, K4.12, Q3.2 (S), Q4.2 (S), Q8.2 (E), R10.2, R13.2, R16.2, U10.3 (AISEN), U10.6 (BISEN), U10.13 (GND), U10.PPAD (P_GND), U11.3 (AISEN), U11.6 (BISEN), U11.13 (GND), U11.PPAD (P_GND); also elsewhere on the board
MINX_1: U10.16 (AIN1); also elsewhere on the board
MINX_2: U10.15 (AIN2); also elsewhere on the board
MINY_1: U11.16 (AIN1); also elsewhere on the board
MINY_2: U11.15 (AIN2); also elsewhere on the board
MINZ_1: U10.9 (BIN1); also elsewhere on the board
MINZ_2: U10.10 (BIN2); also elsewhere on the board
MOX_1: U10.2 (AOUT1); also elsewhere on the board
MOX_2: U10.4 (AOUT2); also elsewhere on the board
MOY_1: U11.2 (AOUT1); also elsewhere on the board
MOY_2: U11.4 (AOUT2); also elsewhere on the board
MOZ_1: U10.7 (BOUT1); also elsewhere on the board
MOZ_2: U10.5 (BOUT2); also elsewhere on the board
MXZ_EN: U10.1 (NSLEEP); also elsewhere on the board
MY_EN: U11.1 (NSLEEP); also elsewhere on the board
unnamed: Q3.3 (D), Q6.4 (G), R8.1
unnamed: Q3.1 (G), R11.1
unnamed: Q4.1 (G), R15.1
unnamed: D3.A, K4.5 (A2), Q8.3 (C)
unnamed: Q4.3 (D), Q7.4 (G), R9.1
VBATT: C10.1, C12.1, C13.1, C14.1, D3.C, K4.1 (A1), K4.14, U10.12 (VM), U11.12 (VM); also elsewhere on the board
VBURN1: Q6.5 (D), Q6.6 (D), Q6.7 (D), Q6.8 (D); also elsewhere on the board
VBURN2: Q7.5 (D), Q7.6 (D), Q7.7 (D), Q7.8 (D); also elsewhere on the board
VBURN_A_IN: K4.11, Q6.1 (S), Q6.2 (S), Q6.3 (S), Q7.1 (S), Q7.2 (S), Q7.3 (S), R8.2, R9.2
VINT_1: C36.1, U10.11 (VREF), U10.14 (VINT)
VINT_2: C37.1, U11.11 (VREF), U11.14 (VINT)

Notes on the sheet:
Power Relay A
Burn Wire Control (Antenna Depolyment)
H-Bridges
Damian Loya, Matt Poole, Tane Tatum

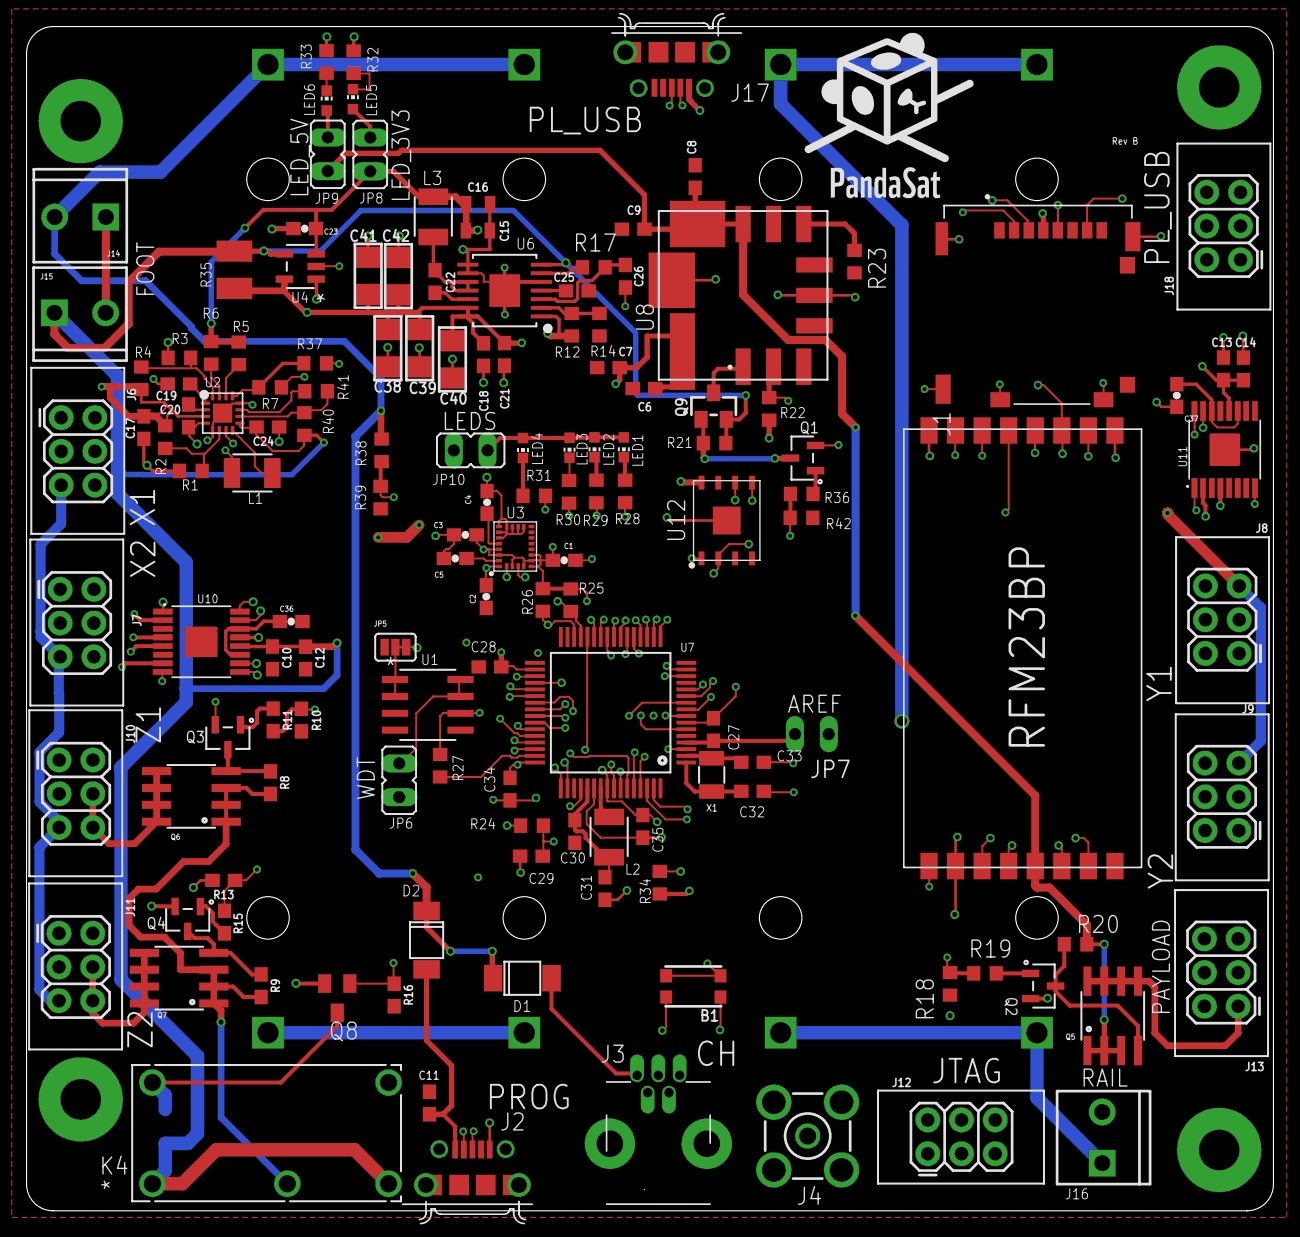
[picture p17: board MB_2.brd from above]

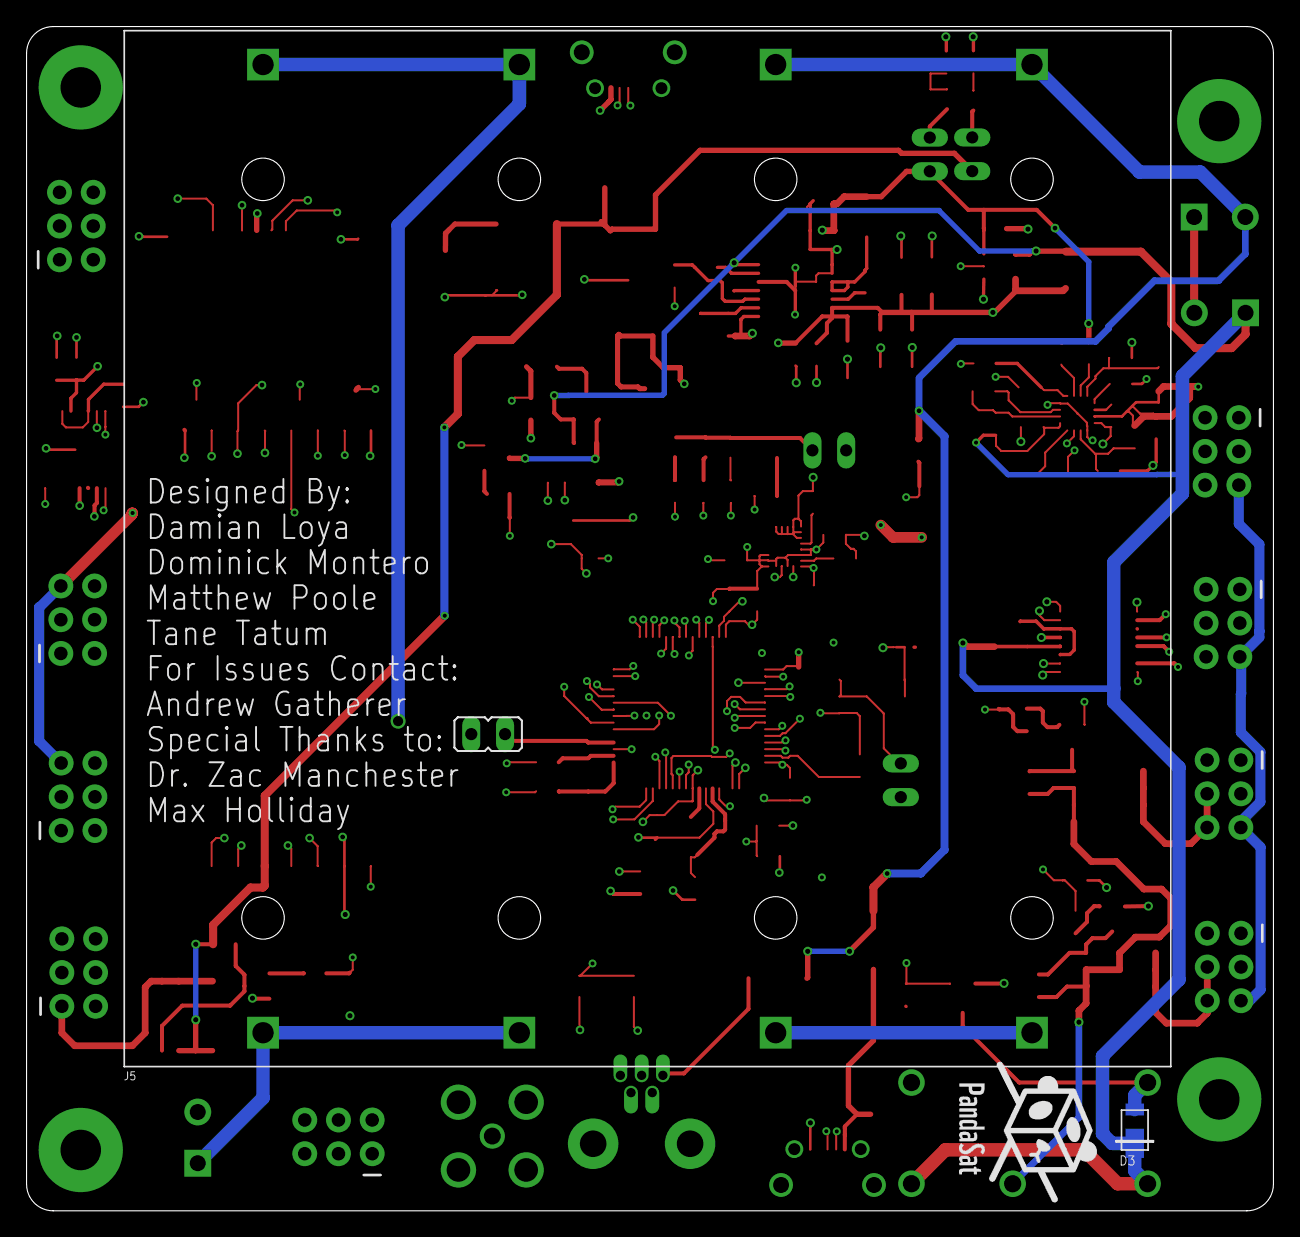
[picture p18: board MB_2.brd from below]

Board: 4 copper layers, 93.9 x 89.2 mm, 143 parts (3 on the bottom side), 121 nets.
