aa236b-winter-2019/FlightBoards/Solar Panel/SolarCellX/SolarCellX_v2_6milmag.brd

## EAGLE design Solar Panel/SolarCellX/SolarCellX_v2_6milmag.brd (2019-03-12)

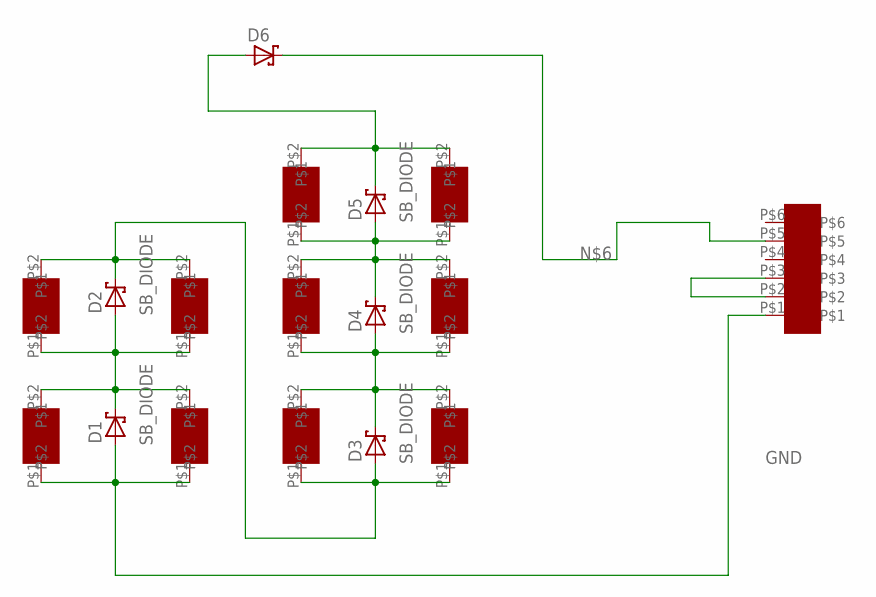
[picture p19: schematic SolarCellX_v2_6milmag.sch]

Parts:
1, 2, 11, 12, 13, 14, 21, 22, 23, 24: SLMD121H04L
D1, D2, D3, D4, D5, D6: SB_DIODE
U$1: M20-8760342

Connections:
GND: 11.P$1, 12.P$1, D1.POS, U$1.P$1
unnamed: U$1.P$2, U$1.P$3
unnamed: 11.P$2, 12.P$2, 13.P$1, 14.P$1, D1.NEG, D2.POS
unnamed: 13.P$2, 14.P$2, 21.P$1, 22.P$1, D2.NEG, D3.POS
unnamed: 1.P$1, 2.P$1, 23.P$2, 24.P$2, D4.NEG, D5.POS
unnamed: 21.P$2, 22.P$2, 23.P$1, 24.P$1, D3.NEG, D4.POS
unnamed: D6.NEG, U$1.P$5
V_SOLAR: 1.P$2, 2.P$2, D5.NEG, D6.POS

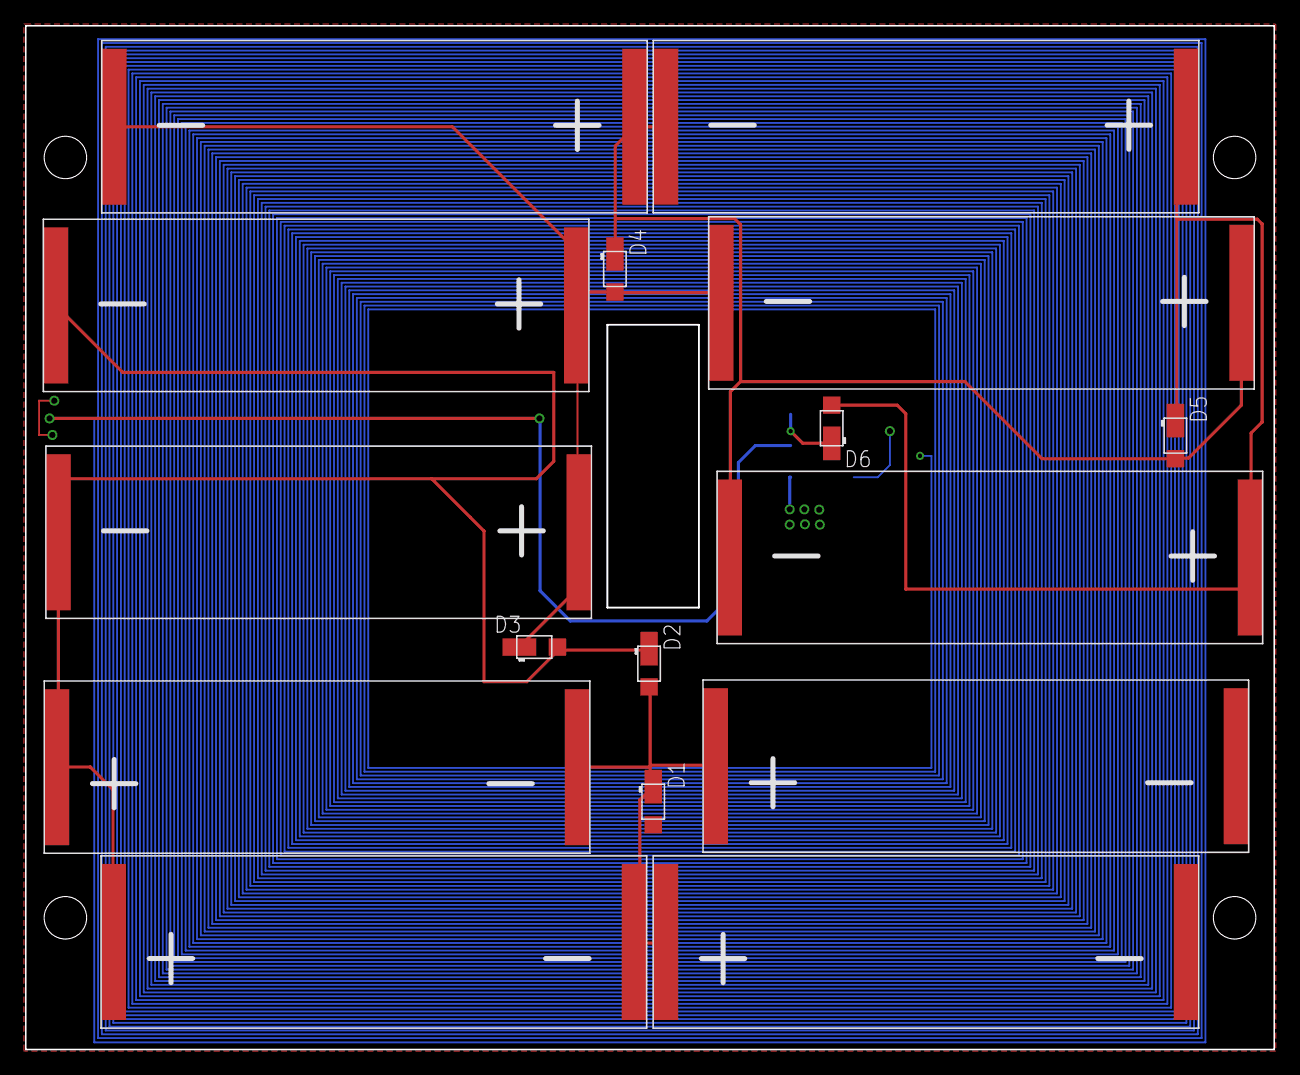
[picture p20: board SolarCellX_v2_6milmag.brd from above]

Board: 4 copper layers, 100.0 x 82.0 mm, 17 parts (1 on the bottom side), 8 nets.
