aa236b-winter-2019/FlightBoards/Solar Panel/SolarCellZ/SolarZ.brd

## EAGLE design Solar Panel/SolarCellZ/SolarZ.brd (continued)

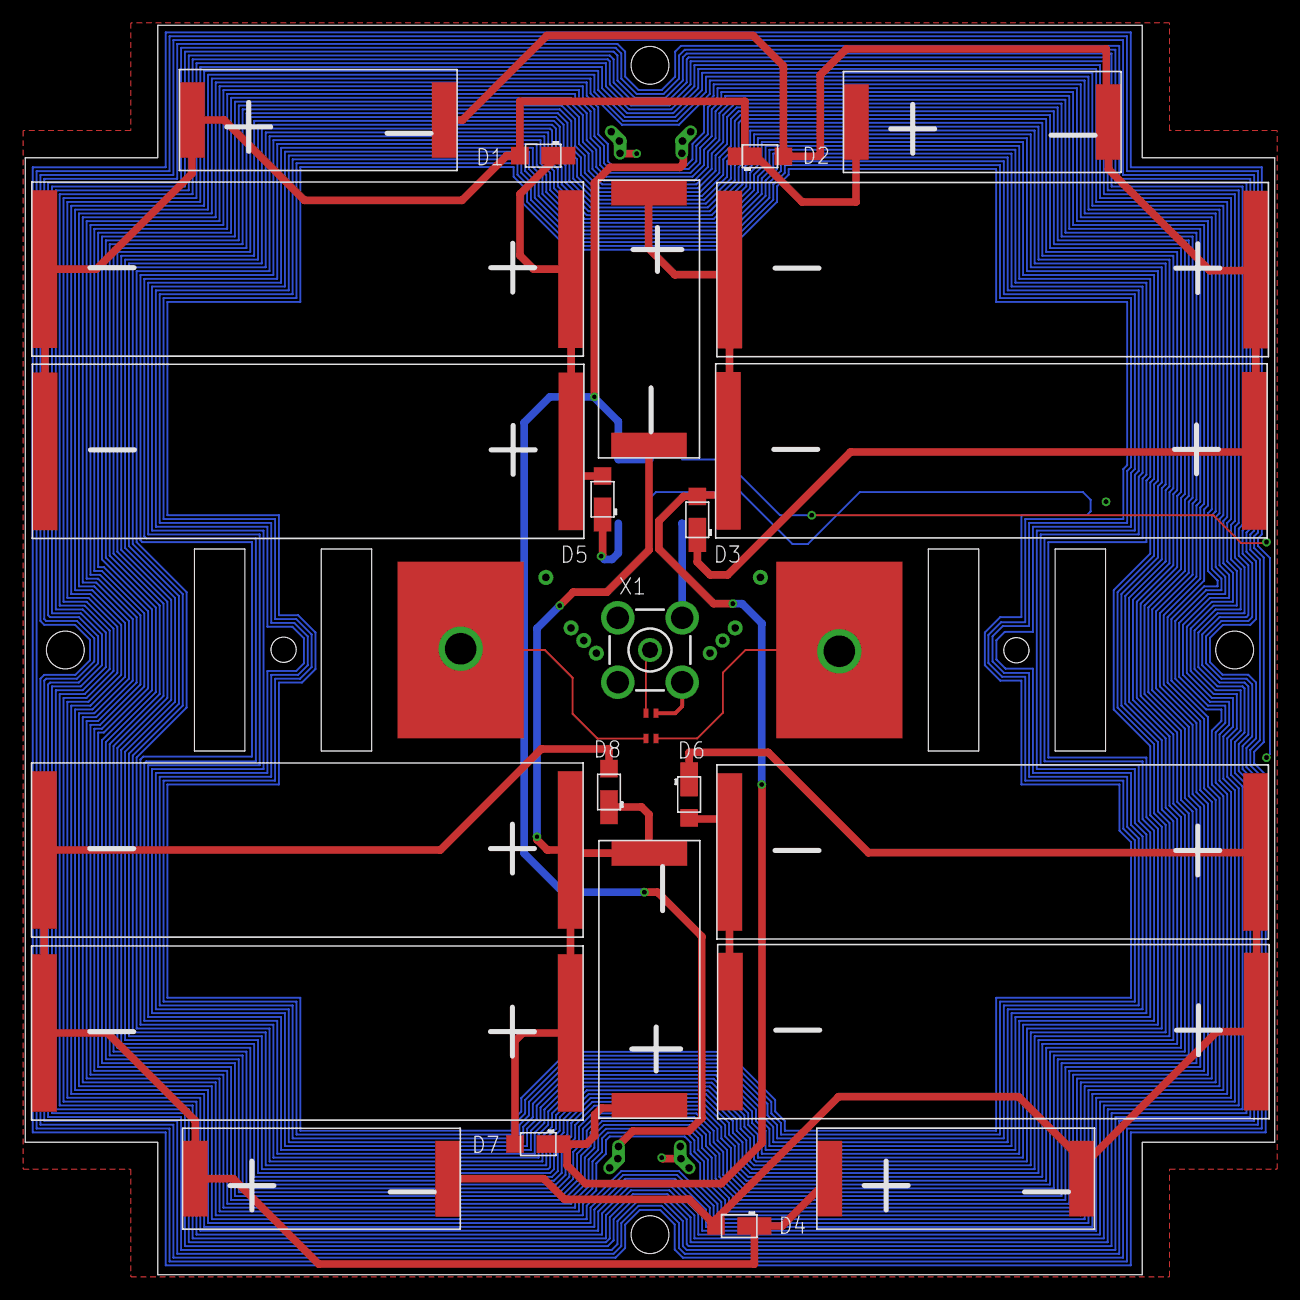
[picture p22: board SolarZ.brd from above]

Board: 4 copper layers, 99.0 x 99.0 mm, 29 parts (1 on the bottom side), 14 nets.
