aa236b-winter-2019/FlightBoards/(commit log)

2019-01-17 Started work on side solar panels
    [SideXSolarPanel.brd, SideXSolarPanel.sch]
2019-01-22 Added useful Motherboard schematic (empty) and useful libraries including custom ATSAMD51
    [MB_1.sch]
2019-01-23 Changed most of major components from KickSat to fit PandaSat
    [MB_1.sch, MB_2.sch]
2019-01-23 Added datasheets
    [MB_2.sch]
2019-01-23 Put charging circuit back in
    [MB_2.sch]
2019-01-23 First rough pass at solar board
    This rough board only includes the panels, the burn wire, and the connector so far
    [SideXSolarPanel.brd, SideXSolarPanel.sch, SolarCellX.brd, SolarCellX.sch]
2019-01-23 5V Power Circuit .. in progress
    [MB_2.sch]
2019-01-24 Updated Watchdog timer & 5V reg
    [MB_2.sch]
2019-01-24 More mobo schematic work incl Hbridge, battery and regulator circuitry
    [MB_2.sch]
2019-01-24 Rearranged schematics and added payload connection
    [MB_2.sch]
2019-01-24 Updated Samd51 symbol, Changed Battery config to 2s2p, Added Power + Osc to MCU
    [MB_2.sch]
2019-01-24 Changed diode on power jack
    [MB_2.sch]
2019-01-24 Added I2C and WDT Interface
    [MB_2.sch]
2019-01-25 Updated Solar Panel with Alex's new sizes
    [DRILEGEND.CFG, SolarCellX.brd, SolarCellX.sch]
2019-01-25 Updated solar cell with larger solar panels
    [SolarCellX_v2.brd, SolarCellX_v2.sch]
2019-01-25 Fixed H-Bridge circuits
    [MB_2.sch]
2019-01-25 Added LEDS, Added decoupling Caps for MCU, Labeled Analog Pins
    [MB_2.sch]
2019-01-25 Added Todos, testing Slack notification
    [MB_2.sch]
2019-01-28 Replaced 4-pin payload connector with 6-pin connector
    [MB_2.sch]
2019-01-28 Routed communication lines and analog signals, changed 5V regulator circuit
    [MB_2.sch]
2019-01-28 aesthetic changes
    [MB_2.sch]
2019-01-28 Added passives to H-Bridges
    [MB_2.sch]
2019-01-29 Edits to Solar cell
    [SolarCellX_v2.brd]
2019-01-29 Added level shifting circuits, added in proper diodes and PFETs, finished routing digital circuitry, changed connectors
    [MB_2.sch]
2019-01-29 Added test points
    [MB_2.sch]
2019-01-31 Set Up PCB stack up , created board outline and PC104 mounting holes
    [DRILEGEND.CFG, MB_2.brd]
2019-01-31 SolarCell X first complete revision
    [SolarCellX_v2.sch, SolarCellX_v2alt.brd, SolarCellX_v2alt.sch]
2019-01-31 Widened traces on solar board and shuffled
    [SolarCellX_v2.brd]
2019-01-31 Changed battery charge circuit, added caps on 3V3 reg input, removed logic level shifting circuit, removed diode on solar panel input
    [MB_2.sch]
2019-01-31 Changing connectors to SMD - not yet netted
    [MB_2.brd, MB_2.sch]
2019-02-01 Finished with schematic, began placing components
    [MB_2.brd, MB_2.sch]
2019-02-01 6mil magnetorquer trace updated
    Barrel jack added
    [SolarCellX_v2.brd, SolarCellX_v2_10milmag.brd, SolarCellX_v2_10milmag.sch, SolarCellX_v2_6milmag.brd, SolarCellX_v2_6milmag.sch]
2019-02-01 Reviewed solar panel board
    [SolarCellX_v2_6milmag.brd]
2019-02-01 Reviewed solar panel board - DRC
    [SolarCellX_v2_6milmag.brd]
2019-02-01 Changed the Connector cutout profile to give some wiggle room for tolerances
    [SolarCellX_v2_6milmag.brd]
2019-02-02 More component placing - power componente
    [MB_2.brd, MB_2.sch]
2019-02-02 Finalized board and gerber files finished
    [SolarCellX_v2_6milmag.brd]
2019-02-02 *Trimmed a mm from long side of PCB *Started Arranging Parts on Board
    Todos:
    Find Parts on Digikey/Mouser and add to BOM spreadsheet [in Documentation BOM]
    Change Footprint on Crystal to SMD [Part in Documentation BOM]
    Verify Footprints of Parts vs parts selected on BOM [package, Pad Sizes, Pin 1 label]
    Change Diode Symbols [3 on Battery Connections]
    Change Foot Print of all 0603 parts to be same one [ Hand solder-able Dimensions] & also other size of passives
    Change Reference designator for FETS from U$# -> Q#
    [MB_2.brd, MB_2.sch]
2019-02-02 * Did Some initial Layout and found a few tasks to do [Listed in Commit Message] Trimmed a mm from long side of PCB Started Arranging Parts on Board
    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
    [MB_2.brd, MB_2.sch]
2019-02-03 Changed several components to fit BOM
    [MB_2.brd, MB_2.sch]
2019-02-04 Added gerbers
2019-02-04 Changed all caps to 0603, need to change to all same part so text size is consistent
    [MB_2.brd, MB_2.sch]
2019-02-04 A bunch of Routing
    [MB_2.brd, MB_2.sch]
2019-02-04 moved parts
    [MB_2.brd]
2019-02-04 Eagle and Git were not getting along
    [MB_2.brd]
2019-02-04 Is this gonna work?
    [MB_2.brd, MB_2.sch]
2019-02-05 More arranging
    [MB_2.brd]
2019-02-05 Changed caps, added new inductor parts, removed fuse
    [MB_2.brd, MB_2.sch]
2019-02-05 Added USB Bypass
    [MB_2.brd, MB_2.sch]
2019-02-05 Switched Barrel Jack to smd Changed Footprints for 2x3 conn to include casing Changed Hbridges to pair x&z instead of x&y fixed mislabeled net PL_PWR_EN -> PL_PWR_ENAB
    Did all the signal routing, just need 5V and 3.3V
    [MB_2.brd, MB_2.sch]
2019-02-06 Finished?!? Rev 1 Routing - DRC < 50 Messages
    Also Added Grnd and Power planes
    Need to Fix LED foot print
    Fix Weird VBatt Node
    [MB_2.brd, MB_2.sch]
2019-02-07 took out extraneous board designs
    [DRILEGEND.CFG, SolarCellX.brd, SolarCellX.sch, SolarCellX_v2.brd, SolarCellX_v2_10milmag.brd, SolarCellX_v2_10milmag.sch, SolarCellX_v2_6milmag.brd, SolarCellX_v2_6milmag.sch]
2019-02-07 Fixed Mounting Hole misalignment and Passing DRC
    [MB_2.brd]
2019-02-07 Added Height attribute motherboard parts
    [MB_2.brd]
2019-02-07 Added CAD model of motherboard
    [MB_2.SLDPRT]
2019-02-07 Corrected foot/rail switch parts
2019-02-07 Added mounting holes to MB CAD model
    [MB_2.SLDPRT]
2019-02-08 Moved Usb Cable
    [MB_2.brd]
2019-02-08 Moved Solar Panels to have Space for mounting hardware
    [SolarCellX_v2_6milmag.brd]
2019-02-08 Updated schematic and MB as per meeting
    [MB_2.brd, MB_2.sch]
2019-02-08 Fixed??? Solar Panel X Final + MB
    [SolarCellX_v2_6milmag.brd]
2019-02-08 Fixed pt2
    [MB_2.brd]
2019-02-08 Fixed last real DRC errors
    [MB_2.brd]
2019-02-08 Re-added schematic frames
    [MB_2.brd, MB_2.sch]
2019-02-08 Added 3d part models
    [RFM-23BP.STEP, USBC_SMD.STEP]
2019-02-08 Rounded corners, added Logo
    [MB_2.brd]
2019-02-08 Solar Panel Gerbers Final X, DRC updates for MB
    [MB_2.brd, SolarCellX_v2_6milmag.brd]
2019-02-09 Updated DRC Rules and fixed up errors
    [MB_2.brd]
2019-02-09 DRC error fixes, changed footprint for USB-C w/ milling layer
    [MB_2.brd, MB_2.sch]
2019-02-11 Finished first pass of solar cell Y with GPS cutout
    [SolarCellY_v2_6milmag.brd, SolarCellY_v2_6milmag.sch]
2019-02-11 Changed connector config and DRC stuff for Y panel
    [MB_2.sch, SolarCellY_v2_6milmag.brd, SolarCellY_v2_6milmag.sch]
2019-02-11 Fixed Silkscreen for Solar Y, Upload Rev A gerbers.
    Sent to BAC:
    PandaSat_MB_RevA4.zip
    SolarCellX_v2_6milmag_RevA.zip
    SolarCellY_v2_6milmag_RevA.zip
    [SolarCellY_v2_6milmag.brd]
2019-02-11 Added Payload Board to Flightboards Repo.
    [PandaSat_Payload.brd, PandaSat_Payload.sch]
2019-02-11 Flipped FTDI circuitry to allow access when Pi installed, addedconnector for USB passthrough from MB
2019-02-12 Finalized Y and created gerbers
    [SolarCellY_v2_6milmag.brd, SolarCellY_v2_6milmag.sch]
2019-02-12 redid some spacing
    [SolarCellY_v2_6milmag.brd]
2019-02-12 Updated MB 3d CAD model
    [MB_2.SLDPRT]
2019-02-12 Moved CAD Folder
    [GPS_Antenna.SLDPRT, MB_2.SLDPRT, RFM-23BP.STEP, USBC_SMD.STEP]
2019-02-12 Changed footprint of LTC4121
    [MB_2.brd, MB_2.sch]
2019-02-14 Began Z panel
    [MB_2.sch, SolarZ.brd, SolarZ.sch]
2019-02-14 Routing on draft Z panel - dimensions need to be confirmed
    [SolarZ.brd, SolarZ.sch]
2019-02-14 Some Magnetorquer routing
    [SolarZ.brd, SolarZ.sch]
2019-02-15 Magnetorquers done
    [SolarZ.brd, SolarZ.sch]
2019-02-15 Added solarZ 3D model
    [SolarZ.SLDPRT]
2019-02-16 Added space around cutouts
    [SolarZ.brd]
2019-02-19 Changed RF trace width
    [SolarZ.brd]
2019-02-20 Resolved a diode issue on SolarCellX and pushed new gerber
    [SolarCellX_v2_6milmag.brd]
2019-02-25 Changed Z panel hole
    [DRILEGEND.CFG, SolarZ.brd, SolarZ.sch]
2019-02-25 Solar Z Panel done passing all DFM checks
    [SolarZ.brd, SolarZ.sch]
2019-02-26 Added Solar-Y CAD model
    [SolarCellY_v2_6milmag.SLDASM]
2019-02-27 Updated schematic + layout but have some git troubles!
    [MB_2.brd, MB_2.sch]
2019-02-27 Fixed lib issue
    [MB_2.brd, MB_2.sch]
2019-02-27 Some MB updates + X Panel CAD update
    [SolarCellX_v2_6milmag.SLDASM]
2019-02-27 Updates to MB
    [MB_2.brd, MB_2.sch, SolarCellX_v2_6milmag.brd]
2019-02-27 Readded frames on schematics
    [MB_2.brd, MB_2.sch]
2019-02-27 Updated 3D solar models
    [SolarCellX_v2_6milmag.SLDASM, SolarCellY_v2_6milmag.SLDASM, SolarZ.SLDASM, SolarZ.SLDPRT]
2019-03-01 Updated to use new solar cell library footprint
    [SolarCellX_v2_6milmag.brd, SolarCellY_v2_6milmag.brd, SolarCellY_v2_6milmag.sch, SolarZ.brd, SolarZ.sch]
2019-03-03 Re-routed traces internally, changed USB-C for Mini USB and changed 5V enable circuit
    [MB_2.brd, MB_2.sch]
2019-03-03 Changed text to Rev B
    [MB_2.brd]
2019-03-03 Added CircuitPython files
2019-03-03 Minor Edits to layout, Ground + Power Floods, Added Names. Maybe Ready?
    [MB_2.brd]
2019-03-04 Cleared more room around bottom battery mounting holes:
    [MB_2.brd]
2019-03-04 Rev 2 Silkscreen
    [MB_2.brd]
2019-03-04 Added DataSheet for button
2019-03-12 Moved magnetorquers and shrunk outside of Z board
    [SolarZ.brd]
2019-03-12 Changed pinout for X, added silkscreen
    [SolarCellX_v2_6milmag.brd, SolarCellX_v2_6milmag.sch]
2019-03-12 Updated circuit python code
2019-03-12 Ground pour for X panel and silkscreen changes for z
    [SolarCellX_v2_6milmag.brd, SolarZ.brd]
2019-03-12 minor rerouting
    [SolarCellX_v2_6milmag.brd]
2019-03-12 Clearance fixes for X plus gerber generation
    [SolarCellX_v2_6milmag.brd]
2019-03-15 Silk Screen Fixes
    [MB_2.brd]
